stefendy-dotcom/NUSA-APRS-ESP32/docs/RF_REMOTE_ADMIN_EN.md

# RF Remote Admin — English

REV1T accepts short configuration commands through **APRS Messages received directly over RF**. All REV1S commands remain available and REV1T adds GPS Tracker control.

## Authorization

The Web UI stores two administrator identities:

- Admin Callsign 1
- Admin Callsign 2

Matching is **exact callsign+SSID**. If `YF9UAG-9` is configured, `YF9UAG` and `YF9UAG-10` are not administrators.

Packets from any other source:

- do not execute the command;
- receive no admin ACK;
- receive no ERR response;
- cause no RF reply transmission;
- may only be logged locally as denied/silent.

Commands arriving through APRS-IS are not used as RF Remote Admin commands. This control path only uses APRS messages successfully decoded from RF.

## How to send a command

Send the command as an **APRS Message addressed to the NUSA APRS device callsign**. The message body only needs to contain one of the short commands below.

Examples:

```text
STAT
DIGI ON
RXGAIN 0
RFPATH WIDE2-1
SAVE
```

If the transmitting APRS application or radio includes a standard APRS message number, the device also sends the normal APRS ACK first.

## Short commands and their functions

| Command | Function |
|---|---|
| `STAT` | Shows a compact device status: uptime, number of received RF packets, DIGI status, IGATE status, APRS-IS connection status, and free heap. |
| `GET` | Shows the current main operational settings in compact form: DIGI, IGATE, IS→RF, RX squelch, RX decoder gain, TX level, and beacon interval. A trailing `*` means there are changes that have not yet been saved. |
| `DIGI ON` / `DIGI OFF` | Enables or disables the **APRS digipeater** function. |
| `IGATE ON` / `IGATE OFF` | Enables or disables the **RF → APRS-IS iGate** function. |
| `ISRF ON` / `ISRF OFF` | Enables or disables **APRS-IS → RF** gating. |
| `RFBCN ON` / `RFBCN OFF` | Enables or disables the device's **position beacon over RF**. |
| `ISBCN ON` / `ISBCN OFF` | Enables or disables the device's **position beacon directly to APRS-IS**. |
| `RXSQL 135` | Sets the **RX Squelch ADC** threshold. Accepted range: **5–1000**. Example: `RXSQL 55`. |
| `RXGAIN 0` | Sets **RX Decoder Gain**. `0` = AUTO. Accepted manual values: **20–500**. |
| `TXLVL 90` | Sets the AFSK TX audio/modulation level. Accepted range: **10–100**. |
| `BSEC 600` | Sets the beacon interval in **seconds**. Accepted range: **30–86400 seconds**. Example: `600` = 10 minutes. |
| `DDELAY 150` | Sets the **digipeater retransmit delay** in milliseconds. Accepted range: **0–3000 ms**. |
| `DUPSEC 30` | Sets the **duplicate-packet suppression window** in seconds. Accepted range: **5–300 seconds**. |
| `FILTER i/30/0` | Sets the local **IS → RF heard filter**. Format: `i/minutes/hops`. Example: `i/30/0` means the station must have been heard over RF within the last 30 minutes with a maximum of 0 used digipeater hops, i.e. heard directly. |
| `ALIAS WIDE1,WIDE2` | Sets the aliases accepted by the digipeater. A common example is `WIDE1,WIDE2`. Maximum alias configuration length is 40 characters. |
| `RFPATH WIDE2-1` | Sets the path used by the device's **RF beacon**. |
| `RFPATH DIRECT` | Sends the RF beacon **without a digipeater path**. |
| `ISPATH WIDE2-1` | Sets the RF path used when forwarding packets from **APRS-IS → RF**. |
| `ISPATH DIRECT` | Sends **APRS-IS → RF** packets directly without a digipeater path. |
| `COMMENT text` | Changes the device APRS comment. Maximum length: **100 characters**. Example: `COMMENT NUSA APRS IGATE`. |
| `AMODE ON` / `AMODE OFF` | Enables/disables **Auto Mode Switch**. ON: APRS-IS online → iGate, offline → Digipeater. While ON, manual `DIGI`/`IGATE` commands return `ERR AUTO`. |
| `TRK ON` / `TRK OFF` | Enables or disables the **REV1T GPS Tracker** independently from Digi/iGate/IS→RF. |
| `GPS` | Requests compact GPS status. Example: `FIX=1 SAT=10 SPD=45 CRS=128`; without fix: `FIX=0 SAT=3`. |
| `TMODE FIX` | Selects **Fixed Interval** tracker mode. |
| `TMODE SMART` | Selects **SmartBeaconing**. |
| `TSEC 120` | Sets the fixed tracker interval. Range **30–3600 seconds**. |
| `TPATH WIDE2-1` | Sets the dedicated tracker RF path. |
| `TPATH DIRECT` | Sends tracker RF direct without a digipeater path. |
| `TOUT RF` | Tracker output is RF only. |
| `TOUT IS` | Tracker output is APRS-IS only. |
| `TOUT BOTH` | Tracker output is RF and APRS-IS. |
| `TBCN` | Requests a **manual tracker beacon**. GPS mode requires a fresh fix; AUTO may use a valid static fallback. RF still uses the TX queue/CSMA. |
| `OLED ON` / `OLED OFF` | Enables or disables the OLED display. |
| `SAVE` | Saves all remote changes to **NVS**, so they remain active after restart or power-off. |
| `CANCEL` | Cancels unsaved remote changes and restores the last saved configuration. |
| `REBOOT` | Remotely restarts the ESP32 after the `OK REBOOT` reply has been queued for RF transmission. |

### REV1T tracker command example

```text
GPS
TRK ON
TMODE SMART
TPATH WIDE2-1
TOUT BOTH
SAVE
```

`TRK`, `TMODE`, `TSEC`, `TPATH` and `TOUT` are remote configuration changes: a trailing `*` means they have not yet been `SAVE`d. `TBCN` only requests a beacon and does not change configuration.

### Meaning of the `STAT` reply

Example:

```text
UP=12H RX=245 D=0 I=1 A=1 IS=1 H=143K
```

- `UP` = device uptime.
- `RX` = number of RF frames received.
- `D=1` = digipeater ON, `D=0` = OFF.
- `I=1` = effective RF→IS iGate ON, `I=0` = OFF.
- `A=1` = Auto Mode Switch ON, `A=0` = OFF/manual.
- `IS=1` = connected to APRS-IS, `IS=0` = disconnected.
- `H` = ESP32 free heap in KB.

### Meaning of the `GET` reply

Example:

```text
D=0 I=1 A=1 R=1 Q=55 G=0 T=90 B=600 *
```

- `D` = DIGI.
- `I` = effective RF→IS IGATE state.
- `A` = Auto Mode Switch (`1` ON, `0` OFF/manual).
- `R` = IS→RF.
- `Q` = RX Squelch ADC.
- `G` = RX Decoder Gain.
- `T` = TX Level.
- `B` = beacon interval in seconds.
- `*` = configuration changes are present but have **not yet been saved**.

## Usage examples

Temporarily disable the digipeater manually (disable Auto Mode first):

```text
AMODE OFF
DIGI OFF
```

If the result is correct and should be made permanent:

```text
SAVE
```

Discard unsaved remote changes:

```text
CANCEL
```

Set the beacon interval to 10 minutes, enable the RF beacon, and use WIDE2-1:

```text
BSEC 600
RFBCN ON
RFPATH WIDE2-1
SAVE
```

Remote changes take effect in RAM first. Use `SAVE` to commit them to NVS. `CANCEL` restores the last saved remote-configurable values.

Administrator identities, station callsign, Wi-Fi credentials, and critical GPIO assignments cannot be changed through RF Remote.

## Security

Exact callsign+SSID whitelisting is an operational control, **not cryptographic authentication**. APRS source callsigns can be spoofed.
