stefendy-dotcom/NUSA-APRS-ESP32/source/NUSA_APRS_IGATE_DIGI_REV1T_GPS_TRACKER/NUSA_APRS_IGATE_DIGI_REV1T_GPS_TRACKER.ino

#include <Arduino.h>
#include <WiFi.h>
#include <WiFiClient.h>
#include <WebServer.h>
#include <Preferences.h>
#include <esp_system.h>
#include <math.h>
#include <strings.h>
#include <Wire.h>

#include "AFSK.h"
#include "AX25.h"
#include "NusaAppTypes.h"
#include "NusaOled.h"
#include "NusaWeather.h"
#include "NusaAprsPosition.h"
#include "NusaGpsTracker.h"
#include "NusaLogo.h"

// ============================================================================
// NUSA APRS iGate + Digipeater REV1T GPS TRACKER / REV1S ENGINE FROZEN
// Target : Classic ESP32 DevKit / WROOM-32
// RX     : GPIO36 (ADC1_CH0)
// TX AFSK: GPIO26 (internal DAC2)
// PTT    : configurable, default GPIO25
// Web    : AP + local Wi-Fi simultaneously
// ============================================================================

static const char *FW_NAME = "NUSA APRS iGate + Digipeater + GPS Tracker";
static const char *FW_VER  = "REV1T GPS TRACKER";
static const char *APRS_SW = "NUSAESP32";
static const char *APRS_SW_VER = "1.6";

WebServer web(80);
Preferences prefs;
WiFiClient aprsClient;
Afsk afsk;
AX25Ctx ax25;
NusaGpsTracker gps;

enum TrackerPositionMode : uint8_t { TRACK_POS_STATIC = 0, TRACK_POS_GPS = 1, TRACK_POS_AUTO = 2 };
enum TrackerOutputMode : uint8_t { TRACK_OUT_RF = 1, TRACK_OUT_IS = 2, TRACK_OUT_BOTH = 3 };
enum TrackerBeaconMode : uint8_t { TRACK_MODE_FIXED = 0, TRACK_MODE_SMART = 1 };

struct TrackerPosition {
  bool valid = false;
  bool fromGps = false;
  double lat = 0.0;
  double lon = 0.0;
  float speedKmh = 0.0f;
  float courseDeg = 0.0f;
  float altitudeM = 0.0f;
  bool courseValid = false;
  bool altitudeValid = false;
};

struct AppConfig {
  String call = "NOCALL";
  uint8_t ssid = 0;
  String dest = "APZUAG";

  String wifiSsid = "";
  String wifiPass = "";
  String apSsid = "NUSA-APRS-IGATE";
  String apPass = "12345678";

  String isServer = "asia.aprs2.net";
  uint16_t isPort = 14580;
  int32_t isPasscode = 0; // 0 = calculate automatically from callsign
  String isFilter = ""; // APRS-IS server-side filter; blank = server default
  bool igateEnabled = true;
  // REV1T Auto Mode Switch:
  // APRS-IS connected => iGate active, Digi inactive.
  // APRS-IS unavailable/disconnected => iGate inactive, Digi active.
  // Manual igate/digi values remain stored as fallback when Auto Mode is OFF.
  bool autoModeSwitchEnabled = true;

  // Local APRS-IS -> RF message filter.  This is processed by the ESP32,
  // NOT sent to APRS-IS.  i/30/0 = message addressee heard in the last
  // 30 minutes with 0 used digipeater hops (direct RF only).
  bool isToRfEnabled = true;
  String localIsRfFilter = "i/30/0";
  String isToRfPath = ""; // blank = direct RF TX

  bool digiEnabled = false;
  String digiAliases = "WIDE1,WIDE2";
  uint16_t digiDelayMs = 150;
  uint16_t duplicateSec = 30;

  bool rfBeaconEnabled = false;
  bool isBeaconEnabled = false;
  uint32_t beaconSec = 600;
  double lat = 0.0;
  double lon = 0.0;
  char symbolTable = '/';
  char symbolCode = '#';
  String comment = "NUSA ESP32 iGate+Digi";
  String rfPath = "WIDE2-1";

  // REV1T additive GPS tracker. Disabled by default so REV1S upgrades remain safe.
  bool trackerEnabled = false;
  uint8_t trackerPositionMode = TRACK_POS_AUTO;
  int gpsRxPin = 16;
  int gpsTxPin = 17;
  uint32_t gpsBaud = 9600;
  uint16_t gpsStaleSec = 15;
  uint8_t trackerOutput = TRACK_OUT_RF;
  String trackerRfPath = "WIDE2-1";
  char trackerSymbolTable = '/';
  char trackerSymbolCode = '>';
  String trackerComment = "NUSA GPS Tracker";
  uint8_t trackerBeaconMode = TRACK_MODE_FIXED;
  uint16_t trackerFixedSec = 120;
  uint16_t smartSlowSpeedKmh = 5;
  uint16_t smartSlowRateSec = 600;
  uint16_t smartFastSpeedKmh = 80;
  uint16_t smartFastRateSec = 60;
  uint16_t smartTurnAngleDeg = 30;
  uint16_t smartTurnSlope = 255;
  uint16_t smartTurnTimeSec = 15;
  uint16_t stationarySpeedKmh = 3;
  uint16_t trackerMinTxSec = 15;

  uint16_t preambleMs = 350;
  uint16_t tailMs = 80;
  uint8_t txLevel = 90;
  uint16_t rxSquelch = 55;
  uint16_t rxDecoderGain = 0; // 0=AUTO, otherwise manual 20..500%

  int pttPin = 25;
  bool pttActiveHigh = true;
  int rxLedPin = 2;
  int txLedPin = 4;

  // Optional SSD1306 128x64 OLED. 0 address = auto detect 0x3C/0x3D.
  bool oledEnabled = true;
  int oledSdaPin = 21;
  int oledSclPin = 22;
  uint8_t oledAddress = 0;
  uint8_t oledController = 2; // 1=SSD1306, 2=SH1106 (default for tested module)
  uint8_t oledContrast = 180;
  bool oledFlip = false;
  uint8_t oledRotateSec = 4;
  uint8_t oledPopupSec = 10;
  uint16_t oledWeatherMaxAgeMin = 30;

  // RF Remote Admin. Admin identity is configured only from the local Web UI.
  // Up to two exact callsign+SSID values are accepted. Empty = unused.
  bool rfAdminEnabled = false;
  String rfAdmin1 = "";
  String rfAdmin2 = "";
  String rfAdminReplyPath = ""; // blank = DIRECT
} cfg;

// Counters
uint32_t rfRxCount = 0;
uint32_t gatedCount = 0;
uint32_t digiTxCount = 0;
uint32_t rfBeaconCount = 0;
uint32_t isBeaconCount = 0;
uint32_t isRxLineCount = 0;
uint32_t isToRfTxCount = 0;
uint32_t isToRfDropCount = 0;
uint32_t droppedTxCount = 0;
uint32_t lastBeaconMs = 0;
uint32_t lastIsConnectAttempt = 0;
uint32_t lastWifiRetry = 0;
uint32_t rfAdminOkCount = 0;
uint32_t rfAdminDeniedCount = 0;
uint32_t rfAdminReplyCount = 0;
uint32_t trackerRfBeaconCount = 0;
uint32_t trackerIsBeaconCount = 0;
uint32_t trackerSmartSpeedCount = 0;
uint32_t trackerSmartTurnCount = 0;
uint32_t trackerDroppedTxCount = 0;
uint32_t lastTrackerBeaconMs = 0;
uint32_t lastTrackerAttemptMs = 0;
float lastTrackerCourseDeg = 0.0f;
bool lastTrackerCourseValid = false;
String lastTrackerReason = "-";
bool lastGpsConnectedState = false;
bool lastGpsFixState = false;
bool gpsHadFixPreviously = false;
int8_t autoModeLast = -1; // -1 unknown, 0 DIGI, 1 IGATE
bool rfAdminDirty = false;
bool rfAdminRebootPending = false;
uint32_t rfAdminRebootRequestedMs = 0;

// Snapshot of the remote-changeable operational values. CANCEL restores this
// snapshot; SAVE updates NVS and then refreshes the snapshot.
struct RfAdminSavedConfig {
  bool igateEnabled = true;
  bool autoModeSwitchEnabled = true;
  bool isToRfEnabled = true;
  bool digiEnabled = false;
  bool rfBeaconEnabled = false;
  bool isBeaconEnabled = false;
  String localIsRfFilter;
  String isToRfPath;
  String digiAliases;
  uint16_t digiDelayMs = 150;
  uint16_t duplicateSec = 30;
  uint32_t beaconSec = 600;
  String rfPath;
  String comment;
  uint8_t txLevel = 90;
  uint16_t rxSquelch = 55;
  uint16_t rxDecoderGain = 0;
  bool oledEnabled = true;
  bool trackerEnabled = false;
  uint8_t trackerBeaconMode = TRACK_MODE_FIXED;
  uint16_t trackerFixedSec = 120;
  String trackerRfPath;
  uint8_t trackerOutput = TRACK_OUT_RF;
};
RfAdminSavedConfig rfAdminSaved;

// Small log ring.
static const uint8_t LOG_LINES = 50;
String logBuf[LOG_LINES];
uint8_t logHead = 0;
uint8_t logUsed = 0;

// RF transmit queue. All RF TX goes through CSMA/channel-busy checking.
static const uint8_t TX_QUEUE_SIZE = 8;
TxJob txQueue[TX_QUEUE_SIZE];
uint8_t txHead = 0, txTail = 0;

DupEntry dupCache[32];
uint8_t dupPos = 0;

// Separate duplicate cache for APRS-IS -> RF message gating.
DupEntry isToRfDupCache[32];
uint8_t isToRfDupPos = 0;

// RF heard table. One timestamp is retained for each observed used-digi-hop
// count. i/30/0 therefore checks only lastByHops[0].
static const uint8_t HEARD_SLOTS = 48;
HeardEntry rfHeard[HEARD_SLOTS];

// Tracks stations observed as Internet-originated (TCPIP*/TCPXX*).
InternetHeardEntry internetHeard[HEARD_SLOTS];

// IS->RF transmit rate limiter: max 6 packets/1 min and 10 packets/5 min.
uint32_t isToRfTxHistory[10] = {0};
uint8_t isToRfTxHistoryPos = 0;

String isLineBuffer;

// OLED / local RF event state. OLED is display-only and never participates
// in the modem timing path.
NusaOled oled;
NusaWeatherData lastWeather;
String lastRfSource = "-";
String lastRfDestination = "-";
String lastRfSummary = "";
uint32_t lastRfEventMs = 0;
uint32_t oledWeatherPopupUntil = 0;
uint32_t oledPacketPopupUntil = 0;
uint32_t oledLastRefreshMs = 0;
uint32_t oledLastPageMs = 0;

uint8_t oledPage = 0;

// Six newest RF stations that supplied a valid APRS position.
// The bearing/distance reference is cfg.lat/cfg.lon (this iGate/digipeater).
struct OledHeardPos {
  bool used = false;
  String call;
  double lat = 0.0;
  double lon = 0.0;
  uint16_t bearingDeg = 0;
  float distanceKm = 0.0f;
  uint32_t whenMs = 0;
};
static const uint8_t OLED_HEARD_ROWS = 6;
OledHeardPos oledHeard[OLED_HEARD_ROWS];       // newest RF position packets
OledHeardPos oledIsHeard[OLED_HEARD_ROWS];     // newest APRS-IS position packets

static bool queueRf(const uint8_t *raw, size_t len, TxKind kind, uint32_t delayMs);
static void noteOledIsHeardPosition(const IsPacketInfo &p);
static void applyModemConfig();
static void initOled();
static bool processRfAdminMessage(const AX25Msg &m);
static void serviceRfAdmin();
static bool autoNetworkAvailable();
static bool effectiveIgateEnabled();
static bool effectiveDigiEnabled();
static void serviceAutoModeSwitch();
static bool gpsPinsSafe();
static void initGps();
static bool sendTrackerBeacon(bool manual, const char *reason);
static void serviceTracker();

static void addLog(const String &s) {
  String line = String(millis() / 1000UL) + "s  " + s;
  Serial.println(line);
  logBuf[logHead] = line;
  logHead = (uint8_t)((logHead + 1) % LOG_LINES);
  if (logUsed < LOG_LINES) ++logUsed;
}

static bool autoNetworkAvailable() {
  // End-to-end criterion: Wi-Fi is associated AND the APRS-IS TCP session is
  // authenticated/connected. This also catches "Wi-Fi connected but Internet
  // unavailable" and APRS-IS route failures, where acting as a digipeater is
  // more useful than pretending the iGate is online.
  return WiFi.status() == WL_CONNECTED && aprsClient.connected();
}

static bool effectiveIgateEnabled() {
  return cfg.autoModeSwitchEnabled ? autoNetworkAvailable() : cfg.igateEnabled;
}

static bool effectiveDigiEnabled() {
  return cfg.autoModeSwitchEnabled ? !autoNetworkAvailable() : cfg.digiEnabled;
}

static void serviceAutoModeSwitch() {
  if (!cfg.autoModeSwitchEnabled) {
    if (autoModeLast != -1) {
      addLog("AUTO MODE OFF -> manual IGATE=" + String(cfg.igateEnabled ? "ON" : "OFF") +
             " DIGI=" + String(cfg.digiEnabled ? "ON" : "OFF"));
      autoModeLast = -1;
    }
    return;
  }
  int8_t mode = autoNetworkAvailable() ? 1 : 0;
  if (mode == autoModeLast) return;
  autoModeLast = mode;
  if (mode == 1) addLog("AUTO MODE -> IGATE (APRS-IS connected), DIGI OFF");
  else addLog("AUTO MODE -> DIGI (Internet/APRS-IS unavailable), IGATE OFF");
}

static String htmlEscape(String s) {
  s.replace("&", "&amp;");
  s.replace("<", "&lt;");
  s.replace(">", "&gt;");
  s.replace("\"", "&quot;");
  s.replace("'", "&#39;");
  return s;
}

static String jsonEscape(String s) {
  s.replace("\\", "\\\\");
  s.replace("\"", "\\\"");
  s.replace("\r", "\\r");
  s.replace("\n", "\\n");
  return s;
}

static String sanitizeBaseCall(String in) {
  in.trim(); in.toUpperCase();
  int dash = in.indexOf('-');
  if (dash >= 0) in = in.substring(0, dash);
  String out;
  for (size_t i = 0; i < in.length() && out.length() < 6; ++i) {
    char c = in[i];
    if (isalnum((unsigned char)c)) out += c;
  }
  return out.length() ? out : String("NOCALL");
}

static String singleLine(String s) {
  s.replace("\r", " ");
  s.replace("\n", " ");
  return s;
}

static String stationCall() {
  String s = sanitizeBaseCall(cfg.call);
  if (cfg.ssid > 0) s += "-" + String(cfg.ssid);
  return s;
}

static String callToString(const AX25Call &c, bool star = false) {
  String s(c.call);
  if (c.ssid > 0) s += "-" + String(c.ssid);
  if (star) s += '*';
  return s;
}

static bool parseCallText(String text, AX25Call &out) {
  text.trim(); text.toUpperCase();
  bool repeated = text.endsWith("*");
  if (repeated) text.remove(text.length() - 1);
  int dash = text.indexOf('-');
  String base = dash >= 0 ? text.substring(0, dash) : text;
  int ssid = dash >= 0 ? text.substring(dash + 1).toInt() : 0;
  base = sanitizeBaseCall(base);
  if (base == "NOCALL" || ssid < 0 || ssid > 15) return false;
  out = ax25_makeCall(base.c_str(), (uint8_t)ssid);
  return true;
}

static uint8_t parsePath(const String &pathText, AX25Call out[AX25_MAX_RPT]) {
  String p = pathText;
  p.trim(); p.toUpperCase();
  if (!p.length()) return 0;
  uint8_t n = 0;
  int start = 0;
  while (start < (int)p.length() && n < AX25_MAX_RPT) {
    int comma = p.indexOf(',', start);
    String token = comma < 0 ? p.substring(start) : p.substring(start, comma);
    token.trim();
    AX25Call c{};
    if (token.length() && parseCallText(token, c)) out[n++] = c;
    if (comma < 0) break;
    start = comma + 1;
  }
  return n;
}

static bool sameCall(const AX25Call &a, const AX25Call &b) {
  return strcasecmp(a.call, b.call) == 0 && a.ssid == b.ssid;
}

static String normalizeCallSsid(String s) {
  s.trim(); s.toUpperCase();
  if (!s.length()) return "";
  int dash = s.indexOf('-');
  if (dash >= 0) {
    String ss = s.substring(dash + 1);
    if (!ss.length() || ss.length() > 2) return "";
    for (size_t i = 0; i < ss.length(); ++i) if (!isdigit((unsigned char)ss[i])) return "";
    int n = ss.toInt();
    if (n < 0 || n > 15) return "";
  }
  AX25Call c{};
  if (!parseCallText(s, c)) return "";
  return callToString(c);
}

static bool rfAdminIsAuthorized(const AX25Call &src) {
  String s = callToString(src); s.toUpperCase();
  return (cfg.rfAdmin1.length() && s == cfg.rfAdmin1) ||
         (cfg.rfAdmin2.length() && s == cfg.rfAdmin2);
}

static bool parseOnOff(String s, bool &v) {
  s.trim(); s.toUpperCase();
  if (s == "ON" || s == "1") { v = true; return true; }
  if (s == "OFF" || s == "0") { v = false; return true; }
  return false;
}

static bool validPathText(String p) {
  p.trim(); p.toUpperCase();
  if (!p.length() || p == "DIRECT") return true;
  uint8_t count = 0;
  int start = 0;
  while (start < (int)p.length()) {
    int comma = p.indexOf(',', start);
    String token = comma < 0 ? p.substring(start) : p.substring(start, comma);
    token.trim();
    if (!token.length()) return false;
    AX25Call c{};
    if (!parseCallText(token, c)) return false;
    if (++count > AX25_MAX_RPT) return false;
    if (comma < 0) break;
    start = comma + 1;
  }
  return count > 0;
}

static String remoteDirtySuffix() { return rfAdminDirty ? " *" : ""; }

static void captureRfAdminSavedConfig() {
  rfAdminSaved.igateEnabled = cfg.igateEnabled;
  rfAdminSaved.autoModeSwitchEnabled = cfg.autoModeSwitchEnabled;
  rfAdminSaved.isToRfEnabled = cfg.isToRfEnabled;
  rfAdminSaved.digiEnabled = cfg.digiEnabled;
  rfAdminSaved.rfBeaconEnabled = cfg.rfBeaconEnabled;
  rfAdminSaved.isBeaconEnabled = cfg.isBeaconEnabled;
  rfAdminSaved.localIsRfFilter = cfg.localIsRfFilter;
  rfAdminSaved.isToRfPath = cfg.isToRfPath;
  rfAdminSaved.digiAliases = cfg.digiAliases;
  rfAdminSaved.digiDelayMs = cfg.digiDelayMs;
  rfAdminSaved.duplicateSec = cfg.duplicateSec;
  rfAdminSaved.beaconSec = cfg.beaconSec;
  rfAdminSaved.rfPath = cfg.rfPath;
  rfAdminSaved.comment = cfg.comment;
  rfAdminSaved.txLevel = cfg.txLevel;
  rfAdminSaved.rxSquelch = cfg.rxSquelch;
  rfAdminSaved.rxDecoderGain = cfg.rxDecoderGain;
  rfAdminSaved.oledEnabled = cfg.oledEnabled;
  rfAdminSaved.trackerEnabled = cfg.trackerEnabled;
  rfAdminSaved.trackerBeaconMode = cfg.trackerBeaconMode;
  rfAdminSaved.trackerFixedSec = cfg.trackerFixedSec;
  rfAdminSaved.trackerRfPath = cfg.trackerRfPath;
  rfAdminSaved.trackerOutput = cfg.trackerOutput;
  rfAdminDirty = false;
}

static void restoreRfAdminSavedConfig() {
  bool oldOled = cfg.oledEnabled;
  cfg.igateEnabled = rfAdminSaved.igateEnabled;
  cfg.autoModeSwitchEnabled = rfAdminSaved.autoModeSwitchEnabled;
  cfg.isToRfEnabled = rfAdminSaved.isToRfEnabled;
  cfg.digiEnabled = rfAdminSaved.digiEnabled;
  cfg.rfBeaconEnabled = rfAdminSaved.rfBeaconEnabled;
  cfg.isBeaconEnabled = rfAdminSaved.isBeaconEnabled;
  cfg.localIsRfFilter = rfAdminSaved.localIsRfFilter;
  cfg.isToRfPath = rfAdminSaved.isToRfPath;
  cfg.digiAliases = rfAdminSaved.digiAliases;
  cfg.digiDelayMs = rfAdminSaved.digiDelayMs;
  cfg.duplicateSec = rfAdminSaved.duplicateSec;
  cfg.beaconSec = rfAdminSaved.beaconSec;
  cfg.rfPath = rfAdminSaved.rfPath;
  cfg.comment = rfAdminSaved.comment;
  cfg.txLevel = rfAdminSaved.txLevel;
  cfg.rxSquelch = rfAdminSaved.rxSquelch;
  cfg.rxDecoderGain = rfAdminSaved.rxDecoderGain;
  cfg.oledEnabled = rfAdminSaved.oledEnabled;
  cfg.trackerEnabled = rfAdminSaved.trackerEnabled;
  cfg.trackerBeaconMode = rfAdminSaved.trackerBeaconMode;
  cfg.trackerFixedSec = rfAdminSaved.trackerFixedSec;
  cfg.trackerRfPath = rfAdminSaved.trackerRfPath;
  cfg.trackerOutput = rfAdminSaved.trackerOutput;
  applyModemConfig();
  if (oldOled && !cfg.oledEnabled && oled.ready()) oled.end();
  if (!oldOled && cfg.oledEnabled && !oled.ready()) initOled();
  rfAdminDirty = false;
}

static void persistRfAdminOperationalConfig() {
  prefs.begin("nusaaprs", false);
  prefs.putBool("igate", cfg.igateEnabled);
  prefs.putBool("automode", cfg.autoModeSwitchEnabled);
  prefs.putBool("is2rf", cfg.isToRfEnabled);
  prefs.putString("isrfflt", cfg.localIsRfFilter);
  prefs.putString("isrfpath", cfg.isToRfPath);
  prefs.putBool("digi", cfg.digiEnabled);
  prefs.putString("alias", cfg.digiAliases);
  prefs.putUShort("ddelay", cfg.digiDelayMs);
  prefs.putUShort("dupsec", cfg.duplicateSec);
  prefs.putBool("rfbcn", cfg.rfBeaconEnabled);
  prefs.putBool("isbcn", cfg.isBeaconEnabled);
  prefs.putUInt("bsec", cfg.beaconSec);
  prefs.putString("comment", cfg.comment);
  prefs.putString("path", cfg.rfPath);
  prefs.putUChar("txlvl", cfg.txLevel);
  prefs.putUShort("rxsql", cfg.rxSquelch);
  prefs.putUShort("rxgain", cfg.rxDecoderGain);
  prefs.putBool("oled", cfg.oledEnabled);
  prefs.putBool("trken", cfg.trackerEnabled);
  prefs.putUChar("trmode", cfg.trackerBeaconMode);
  prefs.putUShort("trsec", cfg.trackerFixedSec);
  prefs.putString("trpath", cfg.trackerRfPath);
  prefs.putUChar("trout", cfg.trackerOutput);
  prefs.end();
  captureRfAdminSavedConfig();
}

static bool aliasAllowed(const AX25Call &c) {
  String list = cfg.digiAliases;
  list.toUpperCase();
  int start = 0;
  while (start <= (int)list.length()) {
    int comma = list.indexOf(',', start);
    String token = comma < 0 ? list.substring(start) : list.substring(start, comma);
    token.trim();
    int dash = token.indexOf('-');
    if (dash >= 0) token = token.substring(0, dash);
    if (token.equalsIgnoreCase(c.call)) return true;
    if (comma < 0) break;
    start = comma + 1;
  }
  return false;
}

static uint32_t packetHash(const AX25Msg &m) {
  uint32_t h = 2166136261UL;
  auto mix = [&](uint8_t b) { h ^= b; h *= 16777619UL; };
  for (const char *p = m.src.call; *p; ++p) mix((uint8_t)*p);
  mix(m.src.ssid);
  for (const char *p = m.dst.call; *p; ++p) mix((uint8_t)*p);
  mix(m.dst.ssid);
  for (size_t i = 0; i < m.len; ++i) mix(m.info[i]);
  return h;
}

static bool duplicateRecently(uint32_t h) {
  uint32_t now = millis();
  uint32_t window = (uint32_t)cfg.duplicateSec * 1000UL;
  for (auto &e : dupCache) {
    if (e.hash == h && (uint32_t)(now - e.when) < window) return true;
  }
  dupCache[dupPos] = {h, now};
  dupPos = (uint8_t)((dupPos + 1) % 32);
  return false;
}

static bool digitsOnly(const String &s) {
  if (!s.length()) return false;
  for (size_t i = 0; i < s.length(); ++i) if (!isdigit((unsigned char)s[i])) return false;
  return true;
}

static LocalIsRfSpec parseLocalIsRfFilter(String f) {
  LocalIsRfSpec spec;
  f.trim(); f.toLowerCase();
  if (!f.startsWith("i/")) return spec;
  int p1 = f.indexOf('/', 2);
  String mins = p1 < 0 ? f.substring(2) : f.substring(2, p1);
  String hops = p1 < 0 ? String("0") : f.substring(p1 + 1);
  if (hops.indexOf('/') >= 0) return spec; // REV1E supports i/time/hops only
  if (!digitsOnly(mins) || !digitsOnly(hops)) return spec;
  int m = mins.toInt();
  int h = hops.toInt();
  if (m < 1 || m > 1440 || h < 0 || h > HEARD_HOPS_MAX) return spec;
  spec.valid = true;
  spec.minutes = (uint16_t)m;
  spec.maxHops = (uint8_t)h;
  return spec;
}

static uint8_t usedDigiHops(const AX25Msg &m) {
  uint8_t hops = 0;
  for (uint8_t i = 0; i < m.rpt_count; ++i) {
    if (m.rpt_flags & BV(i)) ++hops;
  }
  return hops > HEARD_HOPS_MAX ? HEARD_HOPS_MAX : hops;
}

static uint32_t newestHeardMs(const HeardEntry &e) {
  uint32_t newest = 0;
  for (uint8_t h = 0; h <= HEARD_HOPS_MAX; ++h) {
    if (e.lastByHops[h] && (!newest || (int32_t)(e.lastByHops[h] - newest) > 0)) newest = e.lastByHops[h];
  }
  return newest;
}

static int findRfHeardSlot(const String &call, bool create) {
  int freeSlot = -1;
  int oldestSlot = 0;
  uint32_t oldestTime = 0xFFFFFFFFUL;
  for (uint8_t i = 0; i < HEARD_SLOTS; ++i) {
    if (rfHeard[i].used) {
      if (call.equalsIgnoreCase(rfHeard[i].call)) return i;
      uint32_t t = newestHeardMs(rfHeard[i]);
      if (t < oldestTime) { oldestTime = t; oldestSlot = i; }
    } else if (freeSlot < 0) {
      freeSlot = i;
    }
  }
  if (!create) return -1;
  int slot = freeSlot >= 0 ? freeSlot : oldestSlot;
  rfHeard[slot] = HeardEntry();
  rfHeard[slot].used = true;
  strncpy(rfHeard[slot].call, call.c_str(), sizeof(rfHeard[slot].call) - 1);
  rfHeard[slot].call[sizeof(rfHeard[slot].call) - 1] = 0;
  return slot;
}

static void noteRfHeard(const AX25Msg &m) {
  String c = callToString(m.src); c.toUpperCase();
  if (!c.length() || c.equalsIgnoreCase(stationCall())) return;
  int slot = findRfHeardSlot(c, true);
  if (slot < 0) return;
  uint8_t hops = usedDigiHops(m);
  bool wasEligibleDirect = rfHeard[slot].lastByHops[0] &&
      (uint32_t)(millis() - rfHeard[slot].lastByHops[0]) <= 30UL * 60UL * 1000UL;
  rfHeard[slot].lastByHops[hops] = millis();
  if (hops == 0 && !wasEligibleDirect) addLog("HEARD DIRECT + " + c + " (i/30/0 eligible)");
}

static bool rfHeardWithin(const String &call, uint16_t minutes, uint8_t maxHops, uint32_t *ageMs = nullptr) {
  int slot = findRfHeardSlot(call, false);
  if (slot < 0) return false;
  uint32_t now = millis();
  uint32_t window = (uint32_t)minutes * 60UL * 1000UL;
  uint32_t bestAge = 0xFFFFFFFFUL;
  if (maxHops > (uint8_t)HEARD_HOPS_MAX) maxHops = (uint8_t)HEARD_HOPS_MAX;
  for (uint8_t h = 0; h <= maxHops; ++h) {
    uint32_t t = rfHeard[slot].lastByHops[h];
    if (!t) continue;
    uint32_t age = now - t;
    if (age <= window && age < bestAge) bestAge = age;
  }
  if (bestAge == 0xFFFFFFFFUL) return false;
  if (ageMs) *ageMs = bestAge;
  return true;
}

static int findInternetHeardSlot(const String &call, bool create) {
  int freeSlot = -1;
  int oldestSlot = 0;
  uint32_t oldest = 0xFFFFFFFFUL;
  for (uint8_t i = 0; i < HEARD_SLOTS; ++i) {
    if (internetHeard[i].used) {
      if (call.equalsIgnoreCase(internetHeard[i].call)) return i;
      if (internetHeard[i].lastSeen < oldest) { oldest = internetHeard[i].lastSeen; oldestSlot = i; }
    } else if (freeSlot < 0) freeSlot = i;
  }
  if (!create) return -1;
  int slot = freeSlot >= 0 ? freeSlot : oldestSlot;
  internetHeard[slot] = InternetHeardEntry();
  internetHeard[slot].used = true;
  strncpy(internetHeard[slot].call, call.c_str(), sizeof(internetHeard[slot].call) - 1);
  internetHeard[slot].call[sizeof(internetHeard[slot].call) - 1] = 0;
  return slot;
}

static void noteInternetHeard(const String &call) {
  if (!call.length()) return;
  int slot = findInternetHeardSlot(call, true);
  if (slot >= 0) internetHeard[slot].lastSeen = millis();
}

static bool internetHeardWithin(const String &call, uint16_t minutes) {
  int slot = findInternetHeardSlot(call, false);
  if (slot < 0 || !internetHeard[slot].lastSeen) return false;
  return (uint32_t)(millis() - internetHeard[slot].lastSeen) <= (uint32_t)minutes * 60UL * 1000UL;
}

static uint32_t hashStringFNV1a(const String &s) {
  uint32_t h = 2166136261UL;
  for (size_t i = 0; i < s.length(); ++i) { h ^= (uint8_t)s[i]; h *= 16777619UL; }
  return h;
}

static bool isToRfDuplicate(const String &line) {
  uint32_t h = hashStringFNV1a(line);
  uint32_t now = millis();
  const uint32_t window = 30000UL;
  for (auto &e : isToRfDupCache) {
    if (e.hash == h && (uint32_t)(now - e.when) < window) return true;
  }
  isToRfDupCache[isToRfDupPos] = {h, now};
  isToRfDupPos = (uint8_t)((isToRfDupPos + 1) % 32);
  return false;
}

static bool isToRfRateAllowed() {
  uint32_t now = millis();
  uint8_t oneMin = 0, fiveMin = 0;
  for (uint8_t i = 0; i < 10; ++i) {
    if (!isToRfTxHistory[i]) continue;
    uint32_t age = now - isToRfTxHistory[i];
    if (age < 60000UL) ++oneMin;
    if (age < 300000UL) ++fiveMin;
  }
  return oneMin < 6 && fiveMin < 10;
}

static void noteIsToRfTxNow() {
  isToRfTxHistory[isToRfTxHistoryPos] = millis();
  isToRfTxHistoryPos = (uint8_t)((isToRfTxHistoryPos + 1) % 10);
}

static IsPacketInfo parseAprsIsLine(const String &line) {
  IsPacketInfo p;
  if (!line.length() || line[0] == '#') return p;
  int colon = line.indexOf(':');
  int gt = line.indexOf('>');
  if (colon < 0 || gt <= 0 || gt > colon) return p;

  p.src = line.substring(0, gt); p.src.trim(); p.src.toUpperCase();
  String route = line.substring(gt + 1, colon);
  int comma = route.indexOf(',');
  p.dst = comma < 0 ? route : route.substring(0, comma);
  p.dst.trim(); p.dst.toUpperCase();
  p.info = line.substring(colon + 1); // preserve message text exactly
  if (!p.src.length() || !p.dst.length()) return p;

  if (comma >= 0) {
    int start = comma + 1;
    while (start <= (int)route.length()) {
      int c = route.indexOf(',', start);
      String token = c < 0 ? route.substring(start) : route.substring(start, c);
      token.trim(); token.toUpperCase();
      if (token == "TCPXX" || token == "TCPXX*") { p.internetOrigin = true; p.forbiddenToRf = true; }
      if (token == "TCPIP" || token == "TCPIP*") p.internetOrigin = true;
      if (token == "NOGATE" || token == "NOGATE*" || token == "RFONLY" || token == "RFONLY*") p.forbiddenToRf = true;
      if (c < 0) break;
      start = c + 1;
    }
  }

  if (p.info.length() >= 11 && p.info[0] == ':' && p.info[10] == ':') {
    p.addressee = p.info.substring(1, 10);
    p.addressee.trim(); p.addressee.toUpperCase();
    p.message = p.addressee.length() > 0;
  }
  p.valid = true;
  return p;
}

static bool buildIsToRfThirdParty(const IsPacketInfo &p, uint8_t *raw, size_t *rawLen) {
  if (!raw || !rawLen || !p.valid || !p.message) return false;
  AX25Call src = ax25_makeCall(cfg.call.c_str(), cfg.ssid);
  AX25Call dst{};
  if (!parseCallText(cfg.dest, dst)) dst = ax25_makeCall("APNU01", 0);
  AX25Call path[AX25_MAX_RPT]{};
  uint8_t pathCount = parsePath(cfg.isToRfPath, path);

  // Mandatory third-party Internet->RF representation.  APRS-IS q constructs
  // and server path are intentionally discarded.
  String third = "}" + p.src + ">" + p.dst + ",TCPIP," + stationCall() + "*:" + p.info;
  if (third.length() > AX25_MAX_INFO_LEN) return false;
  return ax25_buildUI(raw, rawLen, &dst, &src, path, pathCount, 0,
                      (const uint8_t *)third.c_str(), third.length());
}

static void processAprsIsLine(const String &line) {
  IsPacketInfo p = parseAprsIsLine(line);
  if (!p.valid) return;

  // OLED APRS-IS heard page is intentionally updated BEFORE any local
  // IS->RF eligibility/filter decision.  Therefore a station position can be
  // displayed even when the packet will never be retransmitted to RF.
  noteOledIsHeardPosition(p);

  // Maintain the Internet-heard state even for non-message packets.
  if (p.internetOrigin) noteInternetHeard(p.src);

  if (!cfg.isToRfEnabled || !p.message) return;
  LocalIsRfSpec spec = parseLocalIsRfFilter(cfg.localIsRfFilter);
  if (!spec.valid) {
    ++isToRfDropCount;
    addLog("IS>RF DROP invalid local filter: " + cfg.localIsRfFilter);
    return;
  }

  if (p.forbiddenToRf) {
    ++isToRfDropCount;
    addLog("IS>RF DROP forbidden path: " + p.src + " > " + p.addressee);
    return;
  }
  if (p.addressee.equalsIgnoreCase(stationCall())) return; // message is for this IGate itself

  uint32_t targetAge = 0;
  if (!rfHeardWithin(p.addressee, spec.minutes, spec.maxHops, &targetAge)) {
    ++isToRfDropCount;
    addLog("IS>RF DROP target not i/" + String(spec.minutes) + "/" + String(spec.maxHops) + ": " + p.addressee);
    return;
  }

  // Standard IGate safeguards in addition to the requested i/time/hops rule.
  if (rfHeardWithin(p.src, spec.minutes, HEARD_HOPS_MAX)) {
    ++isToRfDropCount;
    addLog("IS>RF DROP sender also heard on RF: " + p.src);
    return;
  }
  if (internetHeardWithin(p.addressee, spec.minutes)) {
    ++isToRfDropCount;
    addLog("IS>RF DROP target seen on Internet: " + p.addressee);
    return;
  }
  if (isToRfDuplicate(line)) {
    ++isToRfDropCount;
    addLog("IS>RF duplicate suppressed: " + p.src + " > " + p.addressee);
    return;
  }

  uint8_t raw[AX25_MAX_FRAME_LEN];
  size_t rawLen = 0;
  if (!buildIsToRfThirdParty(p, raw, &rawLen)) {
    ++isToRfDropCount;
    addLog("IS>RF DROP packet too long/invalid: " + p.src + " > " + p.addressee);
    return;
  }

  if (queueRf(raw, rawLen, TX_IS_TO_RF, 0)) {
    addLog("IS>RF queued " + p.src + " > " + p.addressee + "  target age=" + String(targetAge / 1000UL) + "s");
  } else {
    ++isToRfDropCount;
  }
}

static bool queueRf(const uint8_t *raw, size_t len, TxKind kind, uint32_t delayMs) {
  if (!raw || len == 0 || len > AX25_MAX_FRAME_LEN) return false;
  uint8_t next = (uint8_t)((txTail + 1) % TX_QUEUE_SIZE);
  if (next == txHead) {
    ++droppedTxCount;
    addLog("RF TX queue full - packet dropped");
    return false;
  }
  txQueue[txTail].len = (uint16_t)len;
  memcpy(txQueue[txTail].data, raw, len);
  txQueue[txTail].queued = millis();
  txQueue[txTail].due = millis() + delayMs;
  txQueue[txTail].kind = kind;
  txTail = next;
  return true;
}

static bool timeReached(uint32_t now, uint32_t target) {
  return (int32_t)(now - target) >= 0;
}

static int aprsPasscode(String call) {
  call.toUpperCase();
  int dash = call.indexOf('-');
  if (dash >= 0) call = call.substring(0, dash);
  uint16_t hash = 0x73E2;
  for (size_t i = 0; i < call.length(); i += 2) {
    hash ^= ((uint16_t)(uint8_t)call[i]) << 8;
    if (i + 1 < call.length()) hash ^= (uint8_t)call[i + 1];
  }
  return hash & 0x7FFF;
}

static bool hasForbiddenGatePath(const AX25Msg &m) {
  for (uint8_t i = 0; i < m.rpt_count; ++i) {
    String c(m.rpt_list[i].call); c.toUpperCase();
    if (c == "TCPIP" || c == "TCPXX" || c == "NOGATE" || c == "RFONLY") return true;
  }
  return m.len > 0 && m.info[0] == '}'; // do not re-gate third-party encapsulated frames
}

static String msgToTnc2(const AX25Msg &m) {
  String line = callToString(m.src) + ">" + callToString(m.dst);
  for (uint8_t i = 0; i < m.rpt_count; ++i) {
    line += ',';
    line += callToString(m.rpt_list[i], (m.rpt_flags & BV(i)) != 0);
  }
  line += ':';
  for (size_t i = 0; i < m.len; ++i) {
    char c = (char)m.info[i];
    if (c == '\r' || c == '\n' || c == 0) continue;
    line += c;
  }
  return line;
}

static void gateToAprsIs(const AX25Msg &m) {
  if (!effectiveIgateEnabled() || !aprsClient.connected() || hasForbiddenGatePath(m)) return;
  if (sameCall(m.src, ax25_makeCall(cfg.call.c_str(), cfg.ssid))) return;

  String rf = msgToTnc2(m);
  int colon = rf.indexOf(':');
  if (colon < 0) return;
  String line = rf.substring(0, colon) + ",qAR," + stationCall() + rf.substring(colon) + "\r\n";
  aprsClient.print(line);
  ++gatedCount;
  addLog("IGATE > IS  " + line.substring(0, line.length() - 2));
}

static void maybeDigipeat(const AX25Msg &m) {
  if (!effectiveDigiEnabled() || m.rpt_count == 0) return;

  AX25Call own = ax25_makeCall(cfg.call.c_str(), cfg.ssid);
  if (sameCall(m.src, own)) return;
  for (uint8_t i = 0; i < m.rpt_count; ++i) {
    if (sameCall(m.rpt_list[i], own) && (m.rpt_flags & BV(i))) return;
  }

  int idx = -1;
  for (uint8_t i = 0; i < m.rpt_count; ++i) {
    if (!(m.rpt_flags & BV(i))) { idx = i; break; }
  }
  if (idx < 0) return;

  bool directOwn = sameCall(m.rpt_list[idx], own);
  bool wideAlias = aliasAllowed(m.rpt_list[idx]) && m.rpt_list[idx].ssid > 0;
  if (!directOwn && !wideAlias) return;

  uint32_t h = packetHash(m);
  if (duplicateRecently(h)) {
    addLog("DIGI duplicate suppressed: " + callToString(m.src));
    return;
  }

  AX25Call newPath[AX25_MAX_RPT]{};
  uint8_t newFlags = 0;
  uint8_t n = 0;

  for (int i = 0; i < idx && n < AX25_MAX_RPT; ++i) {
    newPath[n] = m.rpt_list[i];
    if (m.rpt_flags & BV(i)) newFlags |= BV(n);
    ++n;
  }

  if (directOwn) {
    if (n >= AX25_MAX_RPT) return;
    newPath[n] = own;
    newFlags |= BV(n);
    ++n;
  } else {
    uint8_t hops = m.rpt_list[idx].ssid;
    if (n >= AX25_MAX_RPT) return;
    newPath[n] = own;
    newFlags |= BV(n);
    ++n;
    if (hops > 1) {
      if (n >= AX25_MAX_RPT) return;
      newPath[n] = m.rpt_list[idx];
      newPath[n].ssid = hops - 1;
      ++n;
    }
  }

  for (uint8_t i = (uint8_t)(idx + 1); i < m.rpt_count && n < AX25_MAX_RPT; ++i) {
    newPath[n] = m.rpt_list[i];
    if (m.rpt_flags & BV(i)) newFlags |= BV(n);
    ++n;
  }

  uint8_t raw[AX25_MAX_FRAME_LEN];
  size_t rawLen = 0;
  if (!ax25_buildUI(raw, &rawLen, &m.dst, &m.src, newPath, n, newFlags, m.info, m.len)) return;

  uint32_t dly = cfg.digiDelayMs + (uint32_t)random(0, 51);
  if (queueRf(raw, rawLen, TX_DIGI, dly)) {
    addLog("DIGI queued: " + callToString(m.src) + ">" + callToString(m.dst));
  }
}


static String clipText(String x, uint8_t n) {
  x.replace("\r", " "); x.replace("\n", " "); x.toUpperCase();
  if (x.length() > n) x = x.substring(0, n);
  return x;
}

static String decoderShortName() {
  uint8_t d = AFSK_getLastFrameDecoder();
  if (d == 1) return "A";
  if (d == 2) return "B-RAW";
  if (d == 3) return "B-EQ125";
  if (d == 4) return "B-EQ130";
  return "-";
}

static bool oledPinsSafe() {
  if (cfg.oledSdaPin < 0 || cfg.oledSdaPin > 33 || cfg.oledSclPin < 0 || cfg.oledSclPin > 33) return false;
  if (cfg.oledSdaPin == cfg.oledSclPin) return false;
  if (cfg.oledSdaPin == 26 || cfg.oledSclPin == 26 || cfg.oledSdaPin == 36 || cfg.oledSclPin == 36) return false;
  if (cfg.oledSdaPin == cfg.pttPin || cfg.oledSclPin == cfg.pttPin) return false;
  if (cfg.oledSdaPin == cfg.rxLedPin || cfg.oledSclPin == cfg.rxLedPin) return false;
  if (cfg.oledSdaPin == cfg.txLedPin || cfg.oledSclPin == cfg.txLedPin) return false;
  return true;
}

static void oledHeader(const String &title) {
  oled.fillRect(0, 0, 128, 10, true);
  oled.text(3, 1, title, 1, true);
}


static void oledDrawBitmap128x64(const uint8_t *bmp) {
  if (!bmp) return;
  for (int page = 0; page < 8; ++page) {
    for (int x = 0; x < 128; ++x) {
      uint8_t b = pgm_read_byte(bmp + page * 128 + x);
      for (int bit = 0; bit < 8; ++bit) {
        oled.pixel(x, page * 8 + bit, (b >> bit) & 0x01);
      }
    }
  }
}

static String weatherAgeText() {
  if (!lastWeather.valid) return "-";
  uint32_t age = (millis() - lastWeather.whenMs) / 1000UL;
  if (age < 60) return String(age) + "S";
  return String(age / 60UL) + "M";
}

static void drawOledLogo() {
  oled.clear();
  oledDrawBitmap128x64(NUSA_APRS_LOGO_128X64);
}

static void drawOledHome() {
  oled.clear(); oledHeader("NUSA APRS " + String(FW_VER));
  String call = stationCall();
  oled.centered(14, call, call.length() <= 8 ? 2 : 1);
  bool isok = aprsClient.connected();
  oled.text(1, 34, "IS:" + String(isok ? "OK" : "--") + " IG:" + String(effectiveIgateEnabled() ? "ON" : "OFF"));
  oled.text(1, 43, "DGI:" + String(effectiveDigiEnabled() ? "ON" : "OFF") + " RF:" + String(AFSK_channelBusy() ? "BUSY" : "CLEAR"));
  oled.text(1, 53, "RX:" + String(rfRxCount) + " TX:" + String(digiTxCount));
}

static void drawOledRf() {
  oled.clear(); oledHeader("RF / DECODER");
  oled.text(1, 13, "LAST:" + decoderShortName());
  oled.text(1, 22, "AUDIO:" + String(AFSK_getAudioLevel()) + " G:" + String(AFSK_getAppliedRxGain()) + "%");
  oled.text(1, 31, "RX VALID:" + String(rfRxCount));
  oled.text(1, 40, "RF>IS:" + String(gatedCount) + " DIGI:" + String(digiTxCount));
  oled.text(1, 49, "SRC:" + clipText(lastRfSource, 14));
  oled.text(1, 58, "DST:" + clipText(lastRfDestination, 14));
}

static void drawOledNetwork() {
  oled.clear(); oledHeader("NETWORK");
  String sta = WiFi.status() == WL_CONNECTED ? WiFi.localIP().toString() : "NO STA";
  oled.text(1, 13, "AP:" + WiFi.softAPIP().toString());
  oled.text(1, 22, "STA:" + clipText(sta, 16));
  oled.text(1, 31, "APRS-IS:" + String(aprsClient.connected() ? "CONNECTED" : "OFFLINE"));
  oled.text(1, 40, "IS>RF:" + String(cfg.isToRfEnabled ? "ON" : "OFF"));
  oled.text(1, 49, "HEAP:" + String(ESP.getFreeHeap()));
  oled.text(1, 58, "UP:" + String(millis()/60000UL) + " MIN");
}

static void drawOledLastPacket() {
  oled.clear(); oledHeader("PACKET RF TERAKHIR");
  oled.text(1, 13, "DARI:" + clipText(lastRfSource, 14));
  oled.text(1, 22, "KE  :" + clipText(lastRfDestination, 14));
  String a = lastRfSummary;
  oled.text(1, 33, clipText(a.substring(0, min((int)a.length(), 20)), 20));
  if (a.length() > 20) oled.text(1, 42, clipText(a.substring(20, min((int)a.length(), 40)), 20));
  if (a.length() > 40) oled.text(1, 51, clipText(a.substring(40, min((int)a.length(), 60)), 20));
}

static String fmt1(float v) { return String(v, 1); }

static void drawOledWeather() {
  oled.clear(); oledHeader("WEATHER RF");
  if (!lastWeather.valid) {
    oled.centered(26, "BELUM ADA DATA", 1);
    oled.centered(39, "WEATHER RF", 1);
    return;
  }
  oled.text(1, 12, "DARI:" + clipText(String(lastWeather.source), 13) + " " + weatherAgeText());
  String l1 = "T:";
  l1 += lastWeather.tempValid ? fmt1(lastWeather.tempC) + "C" : "--";
  l1 += " H:";
  l1 += lastWeather.humidityValid ? String(lastWeather.humidity) + "%" : "--";
  oled.text(1, 23, l1);
  String l2 = "P:";
  l2 += lastWeather.pressureValid ? fmt1(lastWeather.pressureHpa) + "HPA" : "--";
  oled.text(1, 33, l2);
  String l3 = "W:";
  l3 += lastWeather.windDirValid ? String(lastWeather.windDirDeg) : "---";
  l3 += "/";
  l3 += lastWeather.windSpeedValid ? fmt1(lastWeather.windSpeedMph * 0.868976f) + "KT" : "--";
  if (lastWeather.gustValid) l3 += " G" + fmt1(lastWeather.gustMph * 0.868976f);
  oled.text(1, 43, l3);
  String l4 = "RAIN:";
  if (lastWeather.rain1hValid) l4 += fmt1(lastWeather.rain1hMm) + "MM/H";
  else if (lastWeather.rain24hValid) l4 += fmt1(lastWeather.rain24hMm) + "MM/24H";
  else l4 += "--";
  oled.text(1, 53, l4);
}


static double degToRad(double d) { return d * 0.017453292519943295769; }

static float distanceKmBetween(double lat1, double lon1, double lat2, double lon2) {
  const double r = 6371.0088;
  double p1 = degToRad(lat1), p2 = degToRad(lat2);
  double dp = degToRad(lat2 - lat1);
  double dl = degToRad(lon2 - lon1);
  double a = sin(dp * 0.5) * sin(dp * 0.5) +
             cos(p1) * cos(p2) * sin(dl * 0.5) * sin(dl * 0.5);
  a = constrain(a, 0.0, 1.0);
  return (float)(r * 2.0 * atan2(sqrt(a), sqrt(1.0 - a)));
}

static uint16_t bearingDegBetween(double lat1, double lon1, double lat2, double lon2) {
  double p1 = degToRad(lat1), p2 = degToRad(lat2);
  double dl = degToRad(lon2 - lon1);
  double y = sin(dl) * cos(p2);
  double x = cos(p1) * sin(p2) - sin(p1) * cos(p2) * cos(dl);
  double b = atan2(y, x) * 57.295779513082320876;
  if (b < 0.0) b += 360.0;
  int v = (int)lround(b);
  if (v >= 360) v -= 360;
  if (v < 0) v += 360;
  return (uint16_t)v;
}

static bool stationReferencePositionReady() {
  if (cfg.lat < -90.0 || cfg.lat > 90.0 || cfg.lon < -180.0 || cfg.lon > 180.0) return false;
  // 0,0 is the factory default and normally means the station position has
  // not been configured yet. Avoid showing meaningless range/bearing.
  if (fabs(cfg.lat) < 0.000001 && fabs(cfg.lon) < 0.000001) return false;
  return true;
}

static void noteOledHeardPosition(const AX25Msg &msg) {
  if (!stationReferencePositionReady()) return;

  double lat = 0.0, lon = 0.0;
  if (!NusaAprsPosition_parse(msg, lat, lon)) return;

  String call = callToString(msg.src);
  call.trim(); call.toUpperCase();
  if (!call.length() || call.equalsIgnoreCase(stationCall())) return;

  OledHeardPos e;
  e.used = true;
  e.call = call;
  e.lat = lat;
  e.lon = lon;
  e.bearingDeg = bearingDegBetween(cfg.lat, cfg.lon, lat, lon);
  e.distanceKm = distanceKmBetween(cfg.lat, cfg.lon, lat, lon);
  e.whenMs = millis();

  int old = -1;
  for (uint8_t i = 0; i < OLED_HEARD_ROWS; ++i) {
    if (oledHeard[i].used && oledHeard[i].call.equalsIgnoreCase(call)) { old = i; break; }
  }

  if (old >= 0) {
    for (int i = old; i > 0; --i) oledHeard[i] = oledHeard[i - 1];
  } else {
    for (int i = OLED_HEARD_ROWS - 1; i > 0; --i) oledHeard[i] = oledHeard[i - 1];
  }
  oledHeard[0] = e;
}

static void noteOledIsHeardPosition(const IsPacketInfo &p) {
  if (!p.valid || !stationReferencePositionReady()) return;

  // Reuse exactly the same APRS position parser used by the RF heard page.
  // Only the source and information field are needed for position decoding.
  AX25Msg msg{};
  if (!parseCallText(p.src, msg.src)) return;
  size_t n = p.info.length();
  if (n == 0) return;
  if (n > AX25_MAX_INFO_LEN) n = AX25_MAX_INFO_LEN;
  memcpy(msg.info, p.info.c_str(), n);
  msg.len = n;

  double lat = 0.0, lon = 0.0;
  if (!NusaAprsPosition_parse(msg, lat, lon)) return;

  String call = p.src;
  call.trim(); call.toUpperCase();
  if (!call.length() || call.equalsIgnoreCase(stationCall())) return;

  OledHeardPos e;
  e.used = true;
  e.call = call;
  e.lat = lat;
  e.lon = lon;
  e.bearingDeg = bearingDegBetween(cfg.lat, cfg.lon, lat, lon);
  e.distanceKm = distanceKmBetween(cfg.lat, cfg.lon, lat, lon);
  e.whenMs = millis();

  int old = -1;
  for (uint8_t i = 0; i < OLED_HEARD_ROWS; ++i) {
    if (oledIsHeard[i].used && oledIsHeard[i].call.equalsIgnoreCase(call)) { old = i; break; }
  }

  if (old >= 0) {
    for (int i = old; i > 0; --i) oledIsHeard[i] = oledIsHeard[i - 1];
  } else {
    for (int i = OLED_HEARD_ROWS - 1; i > 0; --i) oledIsHeard[i] = oledIsHeard[i - 1];
  }
  oledIsHeard[0] = e;
}

static String oledDistanceText(float km) {
  if (!isfinite(km) || km < 0.0f) return "--";
  if (km < 100.0f) return String(km, 1);
  if (km < 1000.0f) return String((int)lroundf(km));
  if (km < 10000.0f) return String((int)lroundf(km));
  return "9999+";
}

static void drawOledHeardStations() {
  oled.clear();
  oledHeader("TERDENGAR     AZ  KM");

  bool any = false;
  for (uint8_t i = 0; i < OLED_HEARD_ROWS; ++i) {
    if (!oledHeard[i].used) continue;
    any = true;

    String call = clipText(oledHeard[i].call, 9);
    while (call.length() < 9) call += ' ';

    char az[5];
    snprintf(az, sizeof(az), "%03u", (unsigned)oledHeard[i].bearingDeg);
    String d = oledDistanceText(oledHeard[i].distanceKm);
    if (d.length() > 5) d = d.substring(0, 5);
    while (d.length() < 5) d = " " + d;

    // 9 call + 1 + 3 azimuth + 1 + 5 km = 19 characters.
    oled.text(1, 11 + (int)i * 9, call + " " + String(az) + " " + d);
  }

  if (!any) {
    oled.centered(27, stationReferencePositionReady() ? "BELUM ADA POSISI RF" : "SET LAT/LON IGATE", 1);
    oled.centered(39, stationReferencePositionReady() ? "DARI STASIUN" : "DI WEB CONFIG", 1);
  }
}

static void drawOledIsHeardStations() {
  oled.clear();
  oledHeader("VIA IS       AZ  KM");

  bool any = false;
  for (uint8_t i = 0; i < OLED_HEARD_ROWS; ++i) {
    if (!oledIsHeard[i].used) continue;
    any = true;

    String call = clipText(oledIsHeard[i].call, 9);
    while (call.length() < 9) call += ' ';

    char az[5];
    snprintf(az, sizeof(az), "%03u", (unsigned)oledIsHeard[i].bearingDeg);
    String d = oledDistanceText(oledIsHeard[i].distanceKm);
    if (d.length() > 5) d = d.substring(0, 5);
    while (d.length() < 5) d = " " + d;

    oled.text(1, 11 + (int)i * 9, call + " " + String(az) + " " + d);
  }

  if (!any) {
    oled.centered(27, stationReferencePositionReady() ? "BELUM ADA POSISI IS" : "SET LAT/LON IGATE", 1);
    oled.centered(39, stationReferencePositionReady() ? "DARI APRS-IS" : "DI WEB CONFIG", 1);
  }
}

static void drawOledGps() {
  oled.clear();
  oledHeader("GPS TRACKER");
  const NusaGpsData &g = gps.data();
  oled.text(2, 12, gps.statusText(cfg.gpsStaleSec));
  oled.text(2, 21, "SAT " + String(g.satellites) + " HDOP " + String(g.hdop, 1));
  if (gps.fixValid(cfg.gpsStaleSec)) {
    oled.text(2, 30, String(g.lat, 5));
    oled.text(2, 39, String(g.lon, 5));
    String mov = "SPD " + String((int)lroundf(g.speedKmh));
    if (g.courseValid) mov += " CRS " + String((int)lroundf(g.courseDeg));
    oled.text(2, 48, mov);
  } else {
    oled.text(2, 30, "WAITING FOR FIX");
    oled.text(2, 39, "RX " + String(cfg.gpsRxPin) + " " + String(cfg.gpsBaud));
    oled.text(2, 48, "TRK " + String(cfg.trackerEnabled ? "ON" : "OFF"));
  }
  String bot = cfg.trackerBeaconMode == TRACK_MODE_SMART ? "SMART" : "FIXED";
  bot += " NXT " + String(trackerNextSeconds()) + "s";
  oled.text(2, 57, bot);
}

static void initOled() {
  if (!cfg.oledEnabled) { addLog("OLED disabled"); return; }
  if (!oledPinsSafe()) { addLog("OLED disabled: GPIO conflict/invalid"); return; }
  bool ok = oled.begin(cfg.oledSdaPin, cfg.oledSclPin, cfg.oledAddress, cfg.oledContrast, cfg.oledFlip, cfg.oledController);
  if (!ok) { addLog("OLED not detected on 0x3C/0x3D"); return; }
  addLog(String("OLED ") + (cfg.oledController==2 ? "SH1106" : "SSD1306") + " ready I2C=0x" + String(oled.address(), HEX) + " SDA=" + String(cfg.oledSdaPin) + " SCL=" + String(cfg.oledSclPin));
  drawOledLogo();
  oled.display();
}

static void serviceOled() {
  if (!oled.ready()) return;
  uint32_t now = millis();
  if ((uint32_t)(now - oledLastRefreshMs) < 1000U) return;
  oledLastRefreshMs = now;

  // Weather has the highest event priority.
  if ((int32_t)(oledWeatherPopupUntil - now) > 0) { drawOledWeather(); oled.display(); return; }
  if ((int32_t)(oledPacketPopupUntil - now) > 0) { drawOledLastPacket(); oled.display(); return; }

  uint32_t rotateSec = cfg.oledRotateSec < 2 ? 2 : cfg.oledRotateSec;
  uint32_t rotateMs = rotateSec * 1000UL;
  if ((uint32_t)(now - oledLastPageMs) >= rotateMs) {
    oledLastPageMs = now;
    oledPage = (uint8_t)((oledPage + 1) % 8);
  }

  // Skip weather page if no fresh weather.
  bool freshWeather = lastWeather.valid &&
    (uint32_t)(now - lastWeather.whenMs) <= (uint32_t)cfg.oledWeatherMaxAgeMin * 60000UL;
  if (oledPage == 7 && !freshWeather) oledPage = 0;

  if (oledPage == 0) drawOledLogo();
  else if (oledPage == 1) drawOledHome();
  else if (oledPage == 2) drawOledNetwork();
  else if (oledPage == 3) drawOledRf();
  else if (oledPage == 4) drawOledHeardStations();
  else if (oledPage == 5) drawOledIsHeardStations();
  else if (oledPage == 6) drawOledGps();
  else drawOledWeather();
  oled.display();
}

static bool extractAprsMessageToThisStation(const AX25Msg &m, String &body, String &msgId) {
  body = ""; msgId = "";
  if (m.len < 11 || m.info[0] != ':' || m.info[10] != ':') return false;
  String to;
  for (uint8_t i = 1; i <= 9; ++i) to += (char)m.info[i];
  to.trim(); to.toUpperCase();
  if (!to.equalsIgnoreCase(stationCall())) return false;
  for (size_t i = 11; i < m.len; ++i) {
    char c = (char)m.info[i];
    if (c && c != '\r' && c != '\n') body += c;
  }
  body.trim();
  int brace = body.lastIndexOf('{');
  if (brace >= 0) {
    String candidate = body.substring(brace + 1); candidate.trim();
    if (candidate.length() > 0 && candidate.length() <= 5 && candidate.indexOf(' ') < 0) {
      msgId = candidate;
      body = body.substring(0, brace); body.trim();
    }
  }
  return body.length() > 0;
}

static bool buildRfAdminReplyRaw(const String &targetCall, const String &reply, uint8_t *raw, size_t *rawLen) {
  if (!raw || !rawLen) return false;
  AX25Call dst{};
  if (!parseCallText(cfg.dest, dst)) dst = ax25_makeCall("APNU01", 0);
  AX25Call src = ax25_makeCall(cfg.call.c_str(), cfg.ssid);
  AX25Call path[AX25_MAX_RPT]{};
  uint8_t pathCount = parsePath(cfg.rfAdminReplyPath, path);
  String a = normalizeCallSsid(targetCall);
  if (!a.length() || a.length() > 9) return false;
  while (a.length() < 9) a += ' ';
  String info = ":" + a + ":" + reply;
  if (info.length() > AX25_MAX_INFO_LEN) info = info.substring(0, AX25_MAX_INFO_LEN);
  return ax25_buildUI(raw, rawLen, &dst, &src, path, pathCount, 0,
                      (const uint8_t *)info.c_str(), info.length());
}

static bool queueRfAdminReply(const String &targetCall, String reply) {
  reply = singleLine(reply); reply.trim();
  if (reply.length() > 67) reply = reply.substring(0, 67);
  uint8_t raw[AX25_MAX_FRAME_LEN]; size_t len = 0;
  if (!buildRfAdminReplyRaw(targetCall, reply, raw, &len)) return false;
  if (!queueRf(raw, len, TX_REMOTE_ADMIN, 150)) return false;
  ++rfAdminReplyCount;
  return true;
}

static String rfAdminGetText() {
  String s = "D=" + String(effectiveDigiEnabled() ? 1 : 0) +
             " I=" + String(effectiveIgateEnabled() ? 1 : 0) +
             " A=" + String(cfg.autoModeSwitchEnabled ? 1 : 0) +
             " R=" + String(cfg.isToRfEnabled ? 1 : 0) +
             " Q=" + String(cfg.rxSquelch) +
             " G=" + String(cfg.rxDecoderGain) +
             " T=" + String(cfg.txLevel) +
             " B=" + String(cfg.beaconSec);
  if (rfAdminDirty) s += " *";
  return s;
}

static String rfAdminStatText() {
  uint32_t upMin = millis() / 60000UL;
  String up = upMin >= 1440UL ? String(upMin / 1440UL) + "D" : String(upMin / 60UL) + "H";
  String s = "UP=" + up + " RX=" + String(rfRxCount) +
             " D=" + String(effectiveDigiEnabled() ? 1 : 0) +
             " I=" + String(effectiveIgateEnabled() ? 1 : 0) +
             " A=" + String(cfg.autoModeSwitchEnabled ? 1 : 0) +
             " IS=" + String(aprsClient.connected() ? 1 : 0) +
             " H=" + String(ESP.getFreeHeap() / 1024UL) + "K";
  return s;
}

static bool setRemoteOnOff(String arg, bool &field) {
  bool v = false;
  if (!parseOnOff(arg, v)) return false;
  field = v; rfAdminDirty = true; return true;
}

static void applyRemoteOledState(bool previous) {
  if (previous && !cfg.oledEnabled && oled.ready()) oled.end();
  if (!previous && cfg.oledEnabled && !oled.ready()) initOled();
}

static bool processRfAdminMessage(const AX25Msg &m) {
  String cmd, msgId;
  if (!extractAprsMessageToThisStation(m, cmd, msgId)) return false;
  if (!cfg.rfAdminEnabled) return false;

  String src = callToString(m.src); src.toUpperCase();
  if (!rfAdminIsAuthorized(m.src)) {
    ++rfAdminDeniedCount;
    addLog("RF ADMIN DENIED SRC=" + src + " (silent)");
    return true; // consumed as a local admin attempt; intentionally no RF reply
  }

  ++rfAdminOkCount;
  // If the admin client attached a standard APRS message number, acknowledge
  // it so normal APRS apps/radios stop retrying. Non-admin never reaches here.
  if (msgId.length()) queueRfAdminReply(src, "ack" + msgId);

  String original = cmd;
  String upper = cmd; upper.toUpperCase(); upper.trim();
  int sp = upper.indexOf(' ');
  String op = sp < 0 ? upper : upper.substring(0, sp);
  String arg = sp < 0 ? String("") : original.substring(sp + 1);
  arg.trim();
  String uarg = arg; uarg.toUpperCase();
  String reply;

  if (op == "STAT") reply = rfAdminStatText();
  else if (op == "GET") reply = rfAdminGetText();
  else if (op == "DIGI") {
    if (cfg.autoModeSwitchEnabled) reply = "ERR AUTO";
    else if (!setRemoteOnOff(uarg, cfg.digiEnabled)) reply = "ERR VALUE";
    else reply = "OK DIGI " + String(cfg.digiEnabled ? "ON" : "OFF") + remoteDirtySuffix();
  } else if (op == "IGATE") {
    if (cfg.autoModeSwitchEnabled) reply = "ERR AUTO";
    else if (!setRemoteOnOff(uarg, cfg.igateEnabled)) reply = "ERR VALUE";
    else reply = "OK IGATE " + String(cfg.igateEnabled ? "ON" : "OFF") + remoteDirtySuffix();
  } else if (op == "AMODE" || op == "AUTO") {
    if (!setRemoteOnOff(uarg, cfg.autoModeSwitchEnabled)) reply = "ERR VALUE";
    else { autoModeLast = -1; serviceAutoModeSwitch(); reply = "OK AMODE " + String(cfg.autoModeSwitchEnabled ? "ON" : "OFF") + remoteDirtySuffix(); }
  } else if (op == "ISRF") {
    if (!setRemoteOnOff(uarg, cfg.isToRfEnabled)) reply = "ERR VALUE";
    else reply = "OK ISRF " + String(cfg.isToRfEnabled ? "ON" : "OFF") + remoteDirtySuffix();
  } else if (op == "RFBCN") {
    if (!setRemoteOnOff(uarg, cfg.rfBeaconEnabled)) reply = "ERR VALUE";
    else reply = "OK RFBCN " + String(cfg.rfBeaconEnabled ? "ON" : "OFF") + remoteDirtySuffix();
  } else if (op == "ISBCN") {
    if (!setRemoteOnOff(uarg, cfg.isBeaconEnabled)) reply = "ERR VALUE";
    else reply = "OK ISBCN " + String(cfg.isBeaconEnabled ? "ON" : "OFF") + remoteDirtySuffix();
  } else if (op == "RXSQL") {
    int v = arg.toInt();
    if (!digitsOnly(arg) || v < 5 || v > 1000) reply = "ERR VALUE";
    else { cfg.rxSquelch = (uint16_t)v; applyModemConfig(); rfAdminDirty = true; reply = "OK RXSQL " + String(v) + remoteDirtySuffix(); }
  } else if (op == "RXGAIN") {
    int v = arg.toInt();
    if (!digitsOnly(arg) || !((v == 0) || (v >= 20 && v <= 500))) reply = "ERR VALUE";
    else { cfg.rxDecoderGain = (uint16_t)v; applyModemConfig(); rfAdminDirty = true; reply = "OK RXGAIN " + String(v) + remoteDirtySuffix(); }
  } else if (op == "TXLVL") {
    int v = arg.toInt();
    if (!digitsOnly(arg) || v < 10 || v > 100) reply = "ERR VALUE";
    else { cfg.txLevel = (uint8_t)v; applyModemConfig(); rfAdminDirty = true; reply = "OK TXLVL " + String(v) + remoteDirtySuffix(); }
  } else if (op == "BSEC") {
    long v = arg.toInt();
    if (!digitsOnly(arg) || v < 30 || v > 86400) reply = "ERR VALUE";
    else { cfg.beaconSec = (uint32_t)v; rfAdminDirty = true; reply = "OK BSEC " + String(v) + remoteDirtySuffix(); }
  } else if (op == "DDELAY") {
    int v = arg.toInt();
    if (!digitsOnly(arg) || v < 0 || v > 3000) reply = "ERR VALUE";
    else { cfg.digiDelayMs = (uint16_t)v; rfAdminDirty = true; reply = "OK DDELAY " + String(v) + remoteDirtySuffix(); }
  } else if (op == "DUPSEC") {
    int v = arg.toInt();
    if (!digitsOnly(arg) || v < 5 || v > 300) reply = "ERR VALUE";
    else { cfg.duplicateSec = (uint16_t)v; rfAdminDirty = true; reply = "OK DUPSEC " + String(v) + remoteDirtySuffix(); }
  } else if (op == "FILTER") {
    String f = uarg; f.toLowerCase();
    if (!parseLocalIsRfFilter(f).valid) reply = "ERR FILTER";
    else { cfg.localIsRfFilter = f; rfAdminDirty = true; reply = "OK FILTER " + f + remoteDirtySuffix(); }
  } else if (op == "ALIAS") {
    String v = uarg; v.trim();
    if (!v.length() || v.length() > 40) reply = "ERR VALUE";
    else { cfg.digiAliases = v; rfAdminDirty = true; reply = "OK ALIAS" + remoteDirtySuffix(); }
  } else if (op == "RFPATH" || op == "ISPATH") {
    String v = uarg; v.trim();
    if (v == "DIRECT") v = "";
    if (!validPathText(v)) reply = "ERR PATH";
    else {
      if (op == "RFPATH") cfg.rfPath = v; else cfg.isToRfPath = v;
      rfAdminDirty = true;
      reply = "OK " + op + " " + (v.length() ? v : String("DIRECT")) + remoteDirtySuffix();
    }
  } else if (op == "COMMENT") {
    String v = singleLine(arg); v.trim();
    if (v.length() > 100) v = v.substring(0, 100);
    cfg.comment = v; rfAdminDirty = true; reply = "OK COMMENT" + remoteDirtySuffix();
  } else if (op == "TRK") {
    if (!setRemoteOnOff(uarg, cfg.trackerEnabled)) reply = "ERR VALUE";
    else reply = "OK TRK " + String(cfg.trackerEnabled ? "ON" : "OFF") + remoteDirtySuffix();
  } else if (op == "GPS") {
    const NusaGpsData &g = gps.data();
    bool fix = gps.fixValid(cfg.gpsStaleSec);
    reply = "FIX=" + String(fix ? 1 : 0) + " SAT=" + String(g.satellites);
    if (fix) {
      reply += " SPD=" + String((int)lroundf(g.speedKmh));
      reply += " CRS=" + String(g.courseValid ? (int)lroundf(g.courseDeg) : 0);
    }
  } else if (op == "TMODE") {
    if (uarg == "FIX" || uarg == "FIXED") cfg.trackerBeaconMode = TRACK_MODE_FIXED;
    else if (uarg == "SMART") cfg.trackerBeaconMode = TRACK_MODE_SMART;
    else { reply = "ERR VALUE"; goto rfadmin_done; }
    rfAdminDirty = true;
    reply = "OK TMODE " + String(cfg.trackerBeaconMode == TRACK_MODE_SMART ? "SMART" : "FIX") + remoteDirtySuffix();
  } else if (op == "TSEC") {
    int v = arg.toInt();
    if (!digitsOnly(arg) || v < 30 || v > 3600) reply = "ERR VALUE";
    else { cfg.trackerFixedSec = (uint16_t)v; rfAdminDirty = true; reply = "OK TSEC " + String(v) + remoteDirtySuffix(); }
  } else if (op == "TPATH") {
    String v = uarg; v.trim();
    if (v == "DIRECT") v = "";
    if (!validPathText(v)) reply = "ERR PATH";
    else { cfg.trackerRfPath = v; rfAdminDirty = true; reply = "OK TPATH " + (v.length() ? v : String("DIRECT")) + remoteDirtySuffix(); }
  } else if (op == "TOUT") {
    if (uarg == "RF") cfg.trackerOutput = TRACK_OUT_RF;
    else if (uarg == "IS") cfg.trackerOutput = TRACK_OUT_IS;
    else if (uarg == "BOTH") cfg.trackerOutput = TRACK_OUT_BOTH;
    else { reply = "ERR VALUE"; goto rfadmin_done; }
    rfAdminDirty = true;
    reply = "OK TOUT " + uarg + remoteDirtySuffix();
  } else if (op == "TBCN") {
    reply = sendTrackerBeacon(true, "ADMIN") ? "OK TBCN" : "ERR NOFIX";
  } else if (op == "OLED") {
    bool old = cfg.oledEnabled;
    if (!setRemoteOnOff(uarg, cfg.oledEnabled)) reply = "ERR VALUE";
    else { applyRemoteOledState(old); reply = "OK OLED " + String(cfg.oledEnabled ? "ON" : "OFF") + remoteDirtySuffix(); }
  } else if (op == "SAVE") {
    persistRfAdminOperationalConfig();
    reply = "OK SAVED";
  } else if (op == "CANCEL") {
    restoreRfAdminSavedConfig();
    reply = "OK CANCEL";
  } else if (op == "REBOOT") {
    reply = "OK REBOOT";
    rfAdminRebootPending = true;
    rfAdminRebootRequestedMs = millis();
  } else {
    reply = "ERR CMD";
  }

rfadmin_done:
  addLog("RF ADMIN " + src + " CMD=" + upper + " -> " + reply);
  queueRfAdminReply(src, reply);
  return true;
}

static void serviceRfAdmin() {
  if (!rfAdminRebootPending) return;
  // Cooperative/non-blocking reboot: give the queued APRS reply time to TX.
  uint32_t age = millis() - rfAdminRebootRequestedMs;
  if (age < 1200UL) return;
  if ((txHead == txTail && !AFSK_isTransmitting()) || age > 10000UL) {
    rfAdminRebootPending = false;
    ESP.restart();
  }
}

static void onAx25Frame(AX25Msg *msg) {
  if (!msg) return;
  ++rfRxCount;
  String tnc = msgToTnc2(*msg);
  uint8_t dec = AFSK_getLastReadDecoder();
  String decName;
  if (dec == 1) decName = "A";
  else if (dec == 2) decName = "B-RAW";
  else if (dec == 3) decName = "B-EQ125";
  else if (dec == 4) decName = "B-EQ130";
  else decName = "?";
  addLog("RF RX [DEC-" + decName + "] " + tnc);

  lastRfSource = callToString(msg->src);
  lastRfDestination = callToString(msg->dst);
  lastRfSummary = "";
  for (size_t i = 0; i < msg->len && lastRfSummary.length() < 90; ++i) {
    char c = (char)msg->info[i];
    if (c && c != '\r' && c != '\n') lastRfSummary += c;
  }
  lastRfEventMs = millis();
  if (cfg.oledEnabled && oled.ready()) oledPacketPopupUntil = millis() + 3000UL;

  // Update the six-row local-station OLED page only when the RF packet
  // contains a valid APRS position.
  noteOledHeardPosition(*msg);

  NusaWeatherData wx;
  if (NusaWeather_parse(*msg, wx)) {
    lastWeather = wx;
    addLog("WEATHER RF < " + String(lastWeather.source) +
           (lastWeather.tempValid ? " T=" + String(lastWeather.tempC,1) + "C" : "") +
           (lastWeather.humidityValid ? " H=" + String(lastWeather.humidity) + "%" : ""));
    if (cfg.oledEnabled && oled.ready()) oledWeatherPopupUntil = millis() + (uint32_t)cfg.oledPopupSec * 1000UL;
  }

  // Learn RF reachability before any iGate/digipeater processing.  A packet
  // with no used repeater H bits is hop 0 and qualifies for i/30/0.
  noteRfHeard(*msg);

  gateToAprsIs(*msg);
  maybeDigipeat(*msg);

  // Additive RF Remote Admin runs after the legacy iGate/digipeater path so
  // existing forwarding/queue order remains unchanged. Non-admin gets no reply.
  processRfAdminMessage(*msg);
}


static bool staticPositionValid() {
  if (!isfinite(cfg.lat) || !isfinite(cfg.lon)) return false;
  if (cfg.lat < -90.0 || cfg.lat > 90.0 || cfg.lon < -180.0 || cfg.lon > 180.0) return false;
  // REV1S defaults are 0,0. Treat that untouched default as "not configured"
  // so AUTO fallback never emits an accidental Gulf of Guinea position.
  return fabs(cfg.lat) > 0.000001 || fabs(cfg.lon) > 0.000001;
}

static bool gpsPinConflicts(int pin) {
  if (pin < 0) return false;
  if (pin == 36 || pin == 26) return true; // frozen APRS RX ADC / TX DAC
  if (pin == cfg.pttPin || pin == cfg.rxLedPin || pin == cfg.txLedPin) return true;
  if (cfg.oledEnabled && (pin == cfg.oledSdaPin || pin == cfg.oledSclPin)) return true;
  return false;
}

static bool gpsPinsSafe() {
  if (cfg.gpsRxPin < 0 || cfg.gpsRxPin > 39) return false;
  if (cfg.gpsTxPin < -1 || cfg.gpsTxPin > 33) return false; // GPIO34..39 are input-only
  if (cfg.gpsTxPin >= 0 && cfg.gpsTxPin == cfg.gpsRxPin) return false;
  if (gpsPinConflicts(cfg.gpsRxPin) || gpsPinConflicts(cfg.gpsTxPin)) return false;
  return true;
}

static void initGps() {
  if (!gpsPinsSafe()) {
    gps.end();
    addLog("GPS disabled: GPIO conflict/invalid");
    return;
  }
  gps.begin(cfg.gpsRxPin, cfg.gpsTxPin, cfg.gpsBaud);
  addLog("GPS UART started RX=GPIO" + String(cfg.gpsRxPin) +
         " TX=" + (cfg.gpsTxPin >= 0 ? String("GPIO") + String(cfg.gpsTxPin) : String("OFF")) +
         " " + String(cfg.gpsBaud) + " baud");
}

static bool getTrackerPosition(TrackerPosition &p) {
  p = TrackerPosition();
  bool gpsOk = gps.fixValid(cfg.gpsStaleSec);
  if (cfg.trackerPositionMode == TRACK_POS_GPS && !gpsOk) return false;

  if ((cfg.trackerPositionMode == TRACK_POS_GPS || cfg.trackerPositionMode == TRACK_POS_AUTO) && gpsOk) {
    const NusaGpsData &g = gps.data();
    p.valid = true;
    p.fromGps = true;
    p.lat = g.lat;
    p.lon = g.lon;
    p.speedKmh = g.speedKmh;
    p.courseDeg = g.courseDeg;
    p.altitudeM = g.altitudeM;
    p.courseValid = g.courseValid;
    p.altitudeValid = g.altitudeValid;
    return true;
  }

  if ((cfg.trackerPositionMode == TRACK_POS_STATIC || cfg.trackerPositionMode == TRACK_POS_AUTO) && staticPositionValid()) {
    p.valid = true;
    p.lat = cfg.lat;
    p.lon = cfg.lon;
    return true;
  }
  return false;
}

static void normalizeAprsDegrees(double value, bool latitude, int &deg, double &minutes, char &hemi) {
  hemi = value >= 0.0 ? (latitude ? 'N' : 'E') : (latitude ? 'S' : 'W');
  double a = fabs(value);
  deg = (int)a;
  minutes = (a - deg) * 60.0;
  minutes = floor(minutes * 100.0 + 0.5) / 100.0;
  if (minutes >= 60.0) { minutes = 0.0; ++deg; }
}

static String trackerPositionPayload(TrackerPosition *used = nullptr) {
  TrackerPosition p;
  if (!getTrackerPosition(p)) return "";
  if (used) *used = p;

  int latDeg = 0, lonDeg = 0;
  double latMin = 0.0, lonMin = 0.0;
  char ns = 'N', ew = 'E';
  normalizeAprsDegrees(p.lat, true, latDeg, latMin, ns);
  normalizeAprsDegrees(p.lon, false, lonDeg, lonMin, ew);

  char b[96];
  snprintf(b, sizeof(b), "!%02d%05.2f%c%c%03d%05.2f%c%c",
           latDeg, latMin, ns, cfg.trackerSymbolTable,
           lonDeg, lonMin, ew, cfg.trackerSymbolCode);
  String payload(b);

  if (p.fromGps && p.courseValid && p.speedKmh > (float)cfg.stationarySpeedKmh) {
    int course = (int)lroundf(p.courseDeg);
    if (course <= 0) course = 360;
    if (course > 360) course = 360;
    int knots = (int)lroundf(p.speedKmh / 1.852f);
    knots = constrain(knots, 0, 999);
    char cs[12];
    snprintf(cs, sizeof(cs), "%03d/%03d", course, knots);
    payload += cs;
  }

  if (p.fromGps && p.altitudeValid) {
    long feet = lroundf(p.altitudeM * 3.28084f);
    if (feet >= 0 && feet <= 999999L) {
      char alt[16];
      snprintf(alt, sizeof(alt), "/A=%06ld", feet);
      payload += alt;
    }
  }

  if (cfg.trackerComment.length()) {
    payload += " ";
    payload += cfg.trackerComment;
  }
  return payload;
}

static bool buildTrackerRaw(uint8_t *raw, size_t *rawLen, String &payload) {
  if (!raw || !rawLen || sanitizeBaseCall(cfg.call) == "NOCALL") return false;
  payload = trackerPositionPayload();
  if (!payload.length()) return false;
  AX25Call src = ax25_makeCall(cfg.call.c_str(), cfg.ssid);
  AX25Call dst{};
  if (!parseCallText(cfg.dest, dst)) dst = ax25_makeCall("APZUAG", 0);
  AX25Call path[AX25_MAX_RPT]{};
  uint8_t pathCount = parsePath(cfg.trackerRfPath, path);
  return ax25_buildUI(raw, rawLen, &dst, &src, path, pathCount, 0,
                      (const uint8_t *)payload.c_str(), payload.length());
}

static bool sendTrackerBeacon(bool manual, const char *reason) {
  if (sanitizeBaseCall(cfg.call) == "NOCALL") return false;
  if (!manual && lastTrackerBeaconMs &&
      (uint32_t)(millis() - lastTrackerBeaconMs) < (uint32_t)cfg.trackerMinTxSec * 1000UL) return false;

  TrackerPosition pos;
  String payload = trackerPositionPayload(&pos);
  if (!payload.length() || !pos.valid) return false;
  if (!manual) lastTrackerAttemptMs = millis();

  bool any = false;
  if (cfg.trackerOutput == TRACK_OUT_RF || cfg.trackerOutput == TRACK_OUT_BOTH) {
    uint8_t raw[AX25_MAX_FRAME_LEN];
    size_t len = 0;
    String rfPayload;
    if (buildTrackerRaw(raw, &len, rfPayload) && queueRf(raw, len, TX_TRACKER, 0)) {
      any = true;
      addLog("TRK RF QUEUED " + String(reason ? reason : "AUTO"));
    } else {
      ++trackerDroppedTxCount;
      addLog("TRK RF DROP queue/build");
    }
  }

  if (cfg.trackerOutput == TRACK_OUT_IS || cfg.trackerOutput == TRACK_OUT_BOTH) {
    if (aprsClient.connected()) {
      String line = stationCall() + ">" + cfg.dest + ",TCPIP*:" + payload + "\r\n";
      aprsClient.print(line);
      ++trackerIsBeaconCount;
      any = true;
      addLog("TRK IS TX " + String(reason ? reason : "AUTO"));
    } else {
      addLog("TRK IS SKIP: APRS-IS disconnected");
    }
  }

  if (any) {
    lastTrackerBeaconMs = millis();
    lastTrackerReason = reason ? String(reason) : String("AUTO");
    if (pos.fromGps && pos.courseValid && pos.speedKmh > (float)cfg.stationarySpeedKmh) {
      lastTrackerCourseDeg = pos.courseDeg;
      lastTrackerCourseValid = true;
    }
  }
  return any;
}

static float headingDelta(float a, float b) {
  float d = fabsf(a - b);
  while (d >= 360.0f) d -= 360.0f;
  return d > 180.0f ? 360.0f - d : d;
}

static uint32_t smartBeaconIntervalSec(float speedKmh) {
  if (speedKmh <= (float)cfg.stationarySpeedKmh || speedKmh <= (float)cfg.smartSlowSpeedKmh)
    return cfg.smartSlowRateSec;
  if (speedKmh >= (float)cfg.smartFastSpeedKmh)
    return cfg.smartFastRateSec;
  uint32_t sec = (uint32_t)lroundf((float)cfg.smartFastRateSec *
                                   (float)cfg.smartFastSpeedKmh / speedKmh);
  if (sec < cfg.smartFastRateSec) sec = cfg.smartFastRateSec;
  if (sec > cfg.smartSlowRateSec) sec = cfg.smartSlowRateSec;
  return sec;
}

static uint32_t trackerNextSeconds() {
  if (!cfg.trackerEnabled) return 0;
  TrackerPosition p;
  if (!getTrackerPosition(p)) return 0;
  uint32_t target = cfg.trackerBeaconMode == TRACK_MODE_SMART ?
                    smartBeaconIntervalSec(p.speedKmh) : cfg.trackerFixedSec;
  if (!lastTrackerBeaconMs) return 0;
  uint32_t elapsed = (uint32_t)(millis() - lastTrackerBeaconMs) / 1000UL;
  return elapsed >= target ? 0 : target - elapsed;
}

static void serviceTracker() {
  bool connected = gps.connected();
  bool fix = gps.fixValid(cfg.gpsStaleSec);
  if (connected != lastGpsConnectedState) {
    if (connected) addLog("GPS CONNECTED");
    else if (lastGpsConnectedState) addLog("GPS LOST");
    lastGpsConnectedState = connected;
  }
  if (fix != lastGpsFixState) {
    if (fix) {
      addLog(gpsHadFixPreviously ? "GPS RESTORED" : "GPS FIX");
      gpsHadFixPreviously = true;
    } else if (lastGpsFixState) {
      addLog(gps.stale(cfg.gpsStaleSec) ? "GPS STALE" : "GPS LOST");
    }
    lastGpsFixState = fix;
  }

  if (!cfg.trackerEnabled) return;
  TrackerPosition p;
  if (!getTrackerPosition(p)) return;

  if (!lastTrackerBeaconMs) {
    sendTrackerBeacon(false, "START");
    return;
  }

  uint32_t elapsedSec = (uint32_t)(millis() - lastTrackerBeaconMs) / 1000UL;
  if (elapsedSec < cfg.trackerMinTxSec) return;
  if (lastTrackerAttemptMs && (uint32_t)(millis() - lastTrackerAttemptMs) < (uint32_t)cfg.trackerMinTxSec * 1000UL) return;

  if (cfg.trackerBeaconMode == TRACK_MODE_FIXED) {
    if (elapsedSec >= cfg.trackerFixedSec) sendTrackerBeacon(false, "FIXED");
    return;
  }

  if (p.fromGps && p.courseValid && lastTrackerCourseValid &&
      p.speedKmh > (float)cfg.stationarySpeedKmh &&
      elapsedSec >= cfg.smartTurnTimeSec) {
    float mph = p.speedKmh * 0.621371f;
    if (mph < 1.0f) mph = 1.0f;
    float threshold = (float)cfg.smartTurnAngleDeg + (float)cfg.smartTurnSlope / mph;
    if (threshold > 180.0f) threshold = 180.0f;
    if (headingDelta(p.courseDeg, lastTrackerCourseDeg) >= threshold) {
      if (sendTrackerBeacon(false, "TURN")) ++trackerSmartTurnCount;
      return;
    }
  }

  uint32_t interval = smartBeaconIntervalSec(p.speedKmh);
  if (elapsedSec >= interval) {
    if (sendTrackerBeacon(false, p.speedKmh <= (float)cfg.stationarySpeedKmh ? "SLOW" : "SPEED"))
      ++trackerSmartSpeedCount;
  }
}

static String aprsPositionPayload() {
  double alat = fabs(cfg.lat), alon = fabs(cfg.lon);
  int latDeg = (int)alat;
  int lonDeg = (int)alon;
  double latMin = (alat - latDeg) * 60.0;
  double lonMin = (alon - lonDeg) * 60.0;
  char b[128];
  char ns = cfg.lat >= 0 ? 'N' : 'S';
  char ew = cfg.lon >= 0 ? 'E' : 'W';
  snprintf(b, sizeof(b), "!%02d%05.2f%c%c%03d%05.2f%c%c",
           latDeg, latMin, ns, cfg.symbolTable,
           lonDeg, lonMin, ew, cfg.symbolCode);
  String s(b);
  if (cfg.comment.length()) s += cfg.comment;
  return s;
}

static bool buildBeaconRaw(uint8_t *raw, size_t *rawLen) {
  if (!raw || !rawLen || sanitizeBaseCall(cfg.call) == "NOCALL") return false;
  AX25Call src = ax25_makeCall(cfg.call.c_str(), cfg.ssid);
  AX25Call dst{};
  if (!parseCallText(cfg.dest, dst)) dst = ax25_makeCall("APNU01", 0);
  AX25Call path[AX25_MAX_RPT]{};
  uint8_t pathCount = parsePath(cfg.rfPath, path);
  String payload = aprsPositionPayload();
  return ax25_buildUI(raw, rawLen, &dst, &src, path, pathCount, 0,
                      (const uint8_t *)payload.c_str(), payload.length());
}

static void sendRfBeacon() {
  uint8_t raw[AX25_MAX_FRAME_LEN];
  size_t len = 0;
  if (!buildBeaconRaw(raw, &len)) {
    addLog("RF beacon skipped: invalid callsign/config");
    return;
  }
  if (queueRf(raw, len, TX_BEACON, 0)) addLog("RF beacon queued");
}

static void sendIsBeacon() {
  // Automatic scheduling is controlled by cfg.isBeaconEnabled in loop().
  // Keeping this function independent allows the WEB "BEACON IS NOW" button
  // to work even when automatic APRS-IS beaconing is disabled.
  if (!aprsClient.connected() || sanitizeBaseCall(cfg.call) == "NOCALL") return;
  String line = stationCall() + ">" + cfg.dest + ",TCPIP*:" + aprsPositionPayload() + "\r\n";
  aprsClient.print(line);
  ++isBeaconCount;
  addLog("BEACON > IS  " + line.substring(0, line.length() - 2));
}

static void serviceRfTx() {
  if (txHead == txTail || AFSK_isTransmitting()) return;
  TxJob &j = txQueue[txHead];
  uint32_t now = millis();
  if (!timeReached(now, j.due)) return;

  if (AFSK_channelBusy()) {
    if ((uint32_t)(now - j.queued) > 5000U) {
      addLog("RF TX dropped: channel busy >5s");
      ++droppedTxCount;
      if (j.kind == TX_IS_TO_RF) ++isToRfDropCount;
      if (j.kind == TX_TRACKER) ++trackerDroppedTxCount;
      txHead = (uint8_t)((txHead + 1) % TX_QUEUE_SIZE);
    }
    return;
  }

  if (j.kind == TX_IS_TO_RF && !isToRfRateAllowed()) {
    addLog("IS>RF DROP rate limit (6/min, 10/5min)");
    ++isToRfDropCount;
    txHead = (uint8_t)((txHead + 1) % TX_QUEUE_SIZE);
    return;
  }

  if (j.kind == TX_DIGI) addLog("RF TX DIGI");
  else if (j.kind == TX_IS_TO_RF) addLog("RF TX IS>RF MESSAGE");
  else if (j.kind == TX_REMOTE_ADMIN) addLog("RF TX ADMIN REPLY");
  else if (j.kind == TX_TRACKER) addLog("TRK RF TX");
  else addLog("RF TX BEACON");

  AFSK_transmit((char *)j.data, j.len);
  if (j.kind == TX_DIGI) ++digiTxCount;
  else if (j.kind == TX_IS_TO_RF) { ++isToRfTxCount; noteIsToRfTxNow(); }
  else if (j.kind == TX_REMOTE_ADMIN) { /* counted when queued */ }
  else if (j.kind == TX_TRACKER) ++trackerRfBeaconCount;
  else ++rfBeaconCount;
  txHead = (uint8_t)((txHead + 1) % TX_QUEUE_SIZE);
}

static void loadConfig() {
  prefs.begin("nusaaprs", true);
  cfg.call = prefs.getString("call", cfg.call);
  cfg.ssid = prefs.getUChar("ssid", cfg.ssid);
  cfg.dest = prefs.getString("dest", cfg.dest);
  cfg.wifiSsid = prefs.getString("wssid", cfg.wifiSsid);
  cfg.wifiPass = prefs.getString("wpass", cfg.wifiPass);
  cfg.apSsid = prefs.getString("apssid", cfg.apSsid);
  cfg.apPass = prefs.getString("appass", cfg.apPass);
  cfg.isServer = prefs.getString("server", cfg.isServer);
  cfg.isPort = prefs.getUShort("port", cfg.isPort);
  cfg.isPasscode = prefs.getInt("ispass", cfg.isPasscode);
  cfg.isFilter = prefs.getString("filter", cfg.isFilter);
  cfg.igateEnabled = prefs.getBool("igate", cfg.igateEnabled);
  cfg.autoModeSwitchEnabled = prefs.getBool("automode", cfg.autoModeSwitchEnabled);
  cfg.isToRfEnabled = prefs.getBool("is2rf", cfg.isToRfEnabled);
  cfg.localIsRfFilter = prefs.getString("isrfflt", cfg.localIsRfFilter);
  cfg.isToRfPath = prefs.getString("isrfpath", cfg.isToRfPath);
  cfg.digiEnabled = prefs.getBool("digi", cfg.digiEnabled);
  cfg.digiAliases = prefs.getString("alias", cfg.digiAliases);
  cfg.digiDelayMs = prefs.getUShort("ddelay", cfg.digiDelayMs);
  cfg.duplicateSec = prefs.getUShort("dupsec", cfg.duplicateSec);
  cfg.rfBeaconEnabled = prefs.getBool("rfbcn", cfg.rfBeaconEnabled);
  cfg.isBeaconEnabled = prefs.getBool("isbcn", cfg.isBeaconEnabled);
  cfg.beaconSec = prefs.getUInt("bsec", cfg.beaconSec);
  cfg.lat = prefs.getDouble("lat", cfg.lat);
  cfg.lon = prefs.getDouble("lon", cfg.lon);
  String st = prefs.getString("symtbl", String(cfg.symbolTable)); if (st.length()) cfg.symbolTable = st[0];
  String sc = prefs.getString("sym", String(cfg.symbolCode)); if (sc.length()) cfg.symbolCode = sc[0];
  cfg.comment = prefs.getString("comment", cfg.comment);
  cfg.rfPath = prefs.getString("path", cfg.rfPath);
  cfg.trackerEnabled = prefs.getBool("trken", cfg.trackerEnabled);
  cfg.trackerPositionMode = prefs.getUChar("posmode", cfg.trackerPositionMode);
  cfg.gpsRxPin = prefs.getInt("gpsrx", cfg.gpsRxPin);
  cfg.gpsTxPin = prefs.getInt("gpstx", cfg.gpsTxPin);
  cfg.gpsBaud = prefs.getUInt("gpsbaud", cfg.gpsBaud);
  cfg.gpsStaleSec = prefs.getUShort("gpsstale", cfg.gpsStaleSec);
  cfg.trackerOutput = prefs.getUChar("trout", cfg.trackerOutput);
  cfg.trackerRfPath = prefs.getString("trpath", cfg.trackerRfPath);
  String tst = prefs.getString("trsymt", String(cfg.trackerSymbolTable)); if (tst.length()) cfg.trackerSymbolTable = tst[0];
  String tsc = prefs.getString("trsym", String(cfg.trackerSymbolCode)); if (tsc.length()) cfg.trackerSymbolCode = tsc[0];
  cfg.trackerComment = prefs.getString("trcomm", cfg.trackerComment);
  cfg.trackerBeaconMode = prefs.getUChar("trmode", cfg.trackerBeaconMode);
  cfg.trackerFixedSec = prefs.getUShort("trsec", cfg.trackerFixedSec);
  cfg.smartSlowSpeedKmh = prefs.getUShort("sslow", cfg.smartSlowSpeedKmh);
  cfg.smartSlowRateSec = prefs.getUShort("srslow", cfg.smartSlowRateSec);
  cfg.smartFastSpeedKmh = prefs.getUShort("sfast", cfg.smartFastSpeedKmh);
  cfg.smartFastRateSec = prefs.getUShort("srfast", cfg.smartFastRateSec);
  cfg.smartTurnAngleDeg = prefs.getUShort("sturn", cfg.smartTurnAngleDeg);
  cfg.smartTurnSlope = prefs.getUShort("sslope", cfg.smartTurnSlope);
  cfg.smartTurnTimeSec = prefs.getUShort("sturnt", cfg.smartTurnTimeSec);
  cfg.stationarySpeedKmh = prefs.getUShort("sstat", cfg.stationarySpeedKmh);
  cfg.trackerMinTxSec = prefs.getUShort("trmin", cfg.trackerMinTxSec);
  cfg.preambleMs = prefs.getUShort("pre", cfg.preambleMs);
  cfg.tailMs = prefs.getUShort("tail", cfg.tailMs);
  cfg.txLevel = prefs.getUChar("txlvl", cfg.txLevel);
  cfg.rxSquelch = prefs.getUShort("rxsql", cfg.rxSquelch);
  cfg.rxDecoderGain = prefs.getUShort("rxgain", cfg.rxDecoderGain);
  uint8_t audioTuneRev = prefs.getUChar("audrev", 0);
  cfg.pttPin = prefs.getInt("pttpin", cfg.pttPin);
  cfg.pttActiveHigh = prefs.getBool("ptthi", cfg.pttActiveHigh);
  cfg.rxLedPin = prefs.getInt("rxled", cfg.rxLedPin);
  cfg.txLedPin = prefs.getInt("txled", cfg.txLedPin);
  cfg.oledEnabled = prefs.getBool("oled", cfg.oledEnabled);
  cfg.oledSdaPin = prefs.getInt("osda", cfg.oledSdaPin);
  cfg.oledSclPin = prefs.getInt("oscl", cfg.oledSclPin);
  cfg.oledAddress = prefs.getUChar("oaddr", cfg.oledAddress);
  cfg.oledController = prefs.getUChar("octrl", cfg.oledController);
  if (cfg.oledController != 1 && cfg.oledController != 2) cfg.oledController = 2;
  cfg.oledContrast = prefs.getUChar("ocon", cfg.oledContrast);
  cfg.oledFlip = prefs.getBool("oflip", cfg.oledFlip);
  cfg.oledRotateSec = prefs.getUChar("orot", cfg.oledRotateSec);
  cfg.oledPopupSec = prefs.getUChar("opop", cfg.oledPopupSec);
  cfg.oledWeatherMaxAgeMin = prefs.getUShort("owxage", cfg.oledWeatherMaxAgeMin);
  cfg.rfAdminEnabled = prefs.getBool("rfadm", cfg.rfAdminEnabled);
  cfg.rfAdmin1 = prefs.getString("rfadm1", cfg.rfAdmin1);
  cfg.rfAdmin2 = prefs.getString("rfadm2", cfg.rfAdmin2);
  cfg.rfAdminReplyPath = prefs.getString("rfadmpath", cfg.rfAdminReplyPath);
  prefs.end();

  cfg.call = sanitizeBaseCall(cfg.call);

  // REV1F keeps the REV1E i/time/hops migration: if it was typed into the old
  // Server filter field, move it to the local device filter automatically.
  String migratedFilter = cfg.isFilter; migratedFilter.trim(); migratedFilter.toLowerCase();
  if (migratedFilter.startsWith("i/")) {
    cfg.localIsRfFilter = cfg.isFilter;
    cfg.isFilter = "";
    cfg.isToRfEnabled = true;
  }
  if (!parseLocalIsRfFilter(cfg.localIsRfFilter).valid) cfg.localIsRfFilter = "i/30/0";
  cfg.isToRfPath.trim(); cfg.isToRfPath.toUpperCase();

  cfg.ssid = constrain(cfg.ssid, (uint8_t)0, (uint8_t)15);
  cfg.lat = constrain(cfg.lat, -90.0, 90.0);
  cfg.lon = constrain(cfg.lon, -180.0, 180.0);
  cfg.txLevel = constrain(cfg.txLevel, (uint8_t)10, (uint8_t)100);
  cfg.rxSquelch = constrain(cfg.rxSquelch, (uint16_t)5, (uint16_t)1000);
  if (cfg.rxDecoderGain != 0) cfg.rxDecoderGain = constrain(cfg.rxDecoderGain, (uint16_t)20, (uint16_t)500);

  // REV1F one-time audio migration. REV1A-E used 65% as the default TX DAC
  // level. If the stored value is still exactly that old default, move it to
  // 90%. Any user-tuned value is preserved.
  if (audioTuneRev < 1) {
    if (cfg.txLevel == 65) cfg.txLevel = 90;
    prefs.begin("nusaaprs", false);
    prefs.putUChar("audrev", 1);
    prefs.putUChar("txlvl", cfg.txLevel);
    prefs.end();
  }
  cfg.beaconSec = constrain(cfg.beaconSec, 30UL, 86400UL);
  cfg.trackerPositionMode = constrain(cfg.trackerPositionMode, (uint8_t)TRACK_POS_STATIC, (uint8_t)TRACK_POS_AUTO);
  if (cfg.gpsBaud != 9600UL && cfg.gpsBaud != 38400UL && cfg.gpsBaud != 115200UL) cfg.gpsBaud = 9600UL;
  cfg.gpsRxPin = constrain(cfg.gpsRxPin, -1, 39);
  cfg.gpsTxPin = constrain(cfg.gpsTxPin, -1, 39);
  cfg.gpsStaleSec = constrain(cfg.gpsStaleSec, (uint16_t)5, (uint16_t)120);
  if (cfg.trackerOutput < TRACK_OUT_RF || cfg.trackerOutput > TRACK_OUT_BOTH) cfg.trackerOutput = TRACK_OUT_RF;
  cfg.trackerRfPath.trim(); cfg.trackerRfPath.toUpperCase();
  if (cfg.trackerRfPath == "DIRECT") cfg.trackerRfPath = "";
  if (!validPathText(cfg.trackerRfPath)) cfg.trackerRfPath = "WIDE2-1";
  cfg.trackerComment = singleLine(cfg.trackerComment); if (cfg.trackerComment.length() > 100) cfg.trackerComment.remove(100);
  if (cfg.trackerBeaconMode > TRACK_MODE_SMART) cfg.trackerBeaconMode = TRACK_MODE_FIXED;
  cfg.trackerFixedSec = constrain(cfg.trackerFixedSec, (uint16_t)30, (uint16_t)3600);
  cfg.smartSlowSpeedKmh = constrain(cfg.smartSlowSpeedKmh, (uint16_t)1, (uint16_t)100);
  cfg.smartSlowRateSec = constrain(cfg.smartSlowRateSec, (uint16_t)60, (uint16_t)3600);
  cfg.smartFastSpeedKmh = constrain(cfg.smartFastSpeedKmh, (uint16_t)10, (uint16_t)300);
  if (cfg.smartFastSpeedKmh <= cfg.smartSlowSpeedKmh) cfg.smartFastSpeedKmh = cfg.smartSlowSpeedKmh + 1;
  cfg.smartFastRateSec = constrain(cfg.smartFastRateSec, (uint16_t)15, (uint16_t)600);
  cfg.smartTurnAngleDeg = constrain(cfg.smartTurnAngleDeg, (uint16_t)5, (uint16_t)90);
  cfg.smartTurnSlope = constrain(cfg.smartTurnSlope, (uint16_t)1, (uint16_t)1000);
  cfg.smartTurnTimeSec = constrain(cfg.smartTurnTimeSec, (uint16_t)5, (uint16_t)120);
  cfg.stationarySpeedKmh = constrain(cfg.stationarySpeedKmh, (uint16_t)0, (uint16_t)30);
  cfg.trackerMinTxSec = constrain(cfg.trackerMinTxSec, (uint16_t)5, (uint16_t)300);
  if (cfg.apPass.length() < 8) cfg.apPass = "12345678";
  cfg.oledSdaPin = constrain(cfg.oledSdaPin, 0, 33);
  cfg.oledSclPin = constrain(cfg.oledSclPin, 0, 33);
  if (cfg.oledAddress != 0x3C && cfg.oledAddress != 0x3D) cfg.oledAddress = 0;
  cfg.oledRotateSec = constrain(cfg.oledRotateSec, (uint8_t)2, (uint8_t)30);
  cfg.oledPopupSec = constrain(cfg.oledPopupSec, (uint8_t)3, (uint8_t)30);
  cfg.oledWeatherMaxAgeMin = constrain(cfg.oledWeatherMaxAgeMin, (uint16_t)1, (uint16_t)1440);
  cfg.rfAdmin1 = normalizeCallSsid(cfg.rfAdmin1);
  cfg.rfAdmin2 = normalizeCallSsid(cfg.rfAdmin2);
  if (cfg.rfAdmin2.length() && cfg.rfAdmin2 == cfg.rfAdmin1) cfg.rfAdmin2 = "";
  cfg.rfAdminReplyPath.trim(); cfg.rfAdminReplyPath.toUpperCase();
  if (cfg.rfAdminReplyPath == "DIRECT") cfg.rfAdminReplyPath = "";
  if (!validPathText(cfg.rfAdminReplyPath)) cfg.rfAdminReplyPath = "";
  if (!cfg.rfAdmin1.length() && !cfg.rfAdmin2.length()) cfg.rfAdminEnabled = false;
}

static void saveConfigFromWeb() {
  cfg.call = sanitizeBaseCall(web.arg("call"));
  cfg.ssid = constrain(web.arg("ssid").toInt(), 0, 15);
  cfg.dest = singleLine(web.arg("dest")); cfg.dest.trim(); cfg.dest.toUpperCase();
  AX25Call destCheck{}; if (!parseCallText(cfg.dest, destCheck)) cfg.dest = "APNU01";
  cfg.wifiSsid = web.arg("wssid");
  if (web.arg("wpass").length()) cfg.wifiPass = web.arg("wpass");
  cfg.apSsid = web.arg("apssid");
  if (cfg.apSsid.length() < 1) cfg.apSsid = "NUSA-APRS-IGATE";
  if (web.arg("appass").length() >= 8) cfg.apPass = web.arg("appass");

  cfg.isServer = singleLine(web.arg("server")); cfg.isServer.trim();
  cfg.isPort = constrain(web.arg("port").toInt(), 1, 65535);
  cfg.isPasscode = web.arg("ispass").toInt();
  cfg.isFilter = singleLine(web.arg("filter")); cfg.isFilter.trim();
  cfg.igateEnabled = web.hasArg("igate");
  cfg.autoModeSwitchEnabled = web.hasArg("automode");

  cfg.isToRfEnabled = web.hasArg("is2rf");
  cfg.localIsRfFilter = singleLine(web.arg("localfilter")); cfg.localIsRfFilter.trim(); cfg.localIsRfFilter.toLowerCase();
  cfg.isToRfPath = singleLine(web.arg("isrfpath")); cfg.isToRfPath.trim(); cfg.isToRfPath.toUpperCase();

  // Friendly migration: i/30/0 typed into Server filter is treated as the
  // local device filter instead of being sent to APRS-IS.
  String serverFilterLower = cfg.isFilter; serverFilterLower.toLowerCase();
  if (serverFilterLower.startsWith("i/")) {
    cfg.localIsRfFilter = cfg.isFilter; cfg.localIsRfFilter.toLowerCase();
    cfg.isFilter = "";
    cfg.isToRfEnabled = true;
  }
  if (!parseLocalIsRfFilter(cfg.localIsRfFilter).valid) cfg.localIsRfFilter = "i/30/0";

  cfg.digiEnabled = web.hasArg("digi");
  cfg.digiAliases = web.arg("alias"); cfg.digiAliases.trim(); cfg.digiAliases.toUpperCase();
  cfg.digiDelayMs = constrain(web.arg("ddelay").toInt(), 0, 3000);
  cfg.duplicateSec = constrain(web.arg("dupsec").toInt(), 5, 300);

  cfg.rfBeaconEnabled = web.hasArg("rfbcn");
  cfg.isBeaconEnabled = web.hasArg("isbcn");
  cfg.beaconSec = constrain((uint32_t)web.arg("bsec").toInt(), 30UL, 86400UL);
  cfg.lat = constrain(web.arg("lat").toDouble(), -90.0, 90.0);
  cfg.lon = constrain(web.arg("lon").toDouble(), -180.0, 180.0);
  String st = web.arg("symtbl"); cfg.symbolTable = st.length() ? st[0] : '/';
  String sc = web.arg("sym"); cfg.symbolCode = sc.length() ? sc[0] : '#';
  cfg.comment = singleLine(web.arg("comment"));
  cfg.rfPath = singleLine(web.arg("path")); cfg.rfPath.trim(); cfg.rfPath.toUpperCase();

  cfg.trackerEnabled = web.hasArg("trken");
  cfg.trackerPositionMode = (uint8_t)constrain(web.arg("posmode").toInt(), 0, 2);
  cfg.gpsRxPin = constrain(web.arg("gpsrx").toInt(), -1, 39);
  cfg.gpsTxPin = constrain(web.arg("gpstx").toInt(), -1, 39);
  {
    uint32_t b = (uint32_t)web.arg("gpsbaud").toInt();
    cfg.gpsBaud = (b == 38400UL || b == 115200UL) ? b : 9600UL;
  }
  cfg.gpsStaleSec = (uint16_t)constrain(web.arg("gpsstale").toInt(), 5, 120);
  cfg.trackerOutput = (uint8_t)constrain(web.arg("trout").toInt(), 1, 3);
  cfg.trackerRfPath = singleLine(web.arg("trpath")); cfg.trackerRfPath.trim(); cfg.trackerRfPath.toUpperCase();
  if (cfg.trackerRfPath == "DIRECT") cfg.trackerRfPath = "";
  if (!validPathText(cfg.trackerRfPath)) cfg.trackerRfPath = "WIDE2-1";
  String tst = web.arg("trsymt"); cfg.trackerSymbolTable = tst.length() ? tst[0] : '/';
  String tsc = web.arg("trsym"); cfg.trackerSymbolCode = tsc.length() ? tsc[0] : '>';
  cfg.trackerComment = singleLine(web.arg("trcomm")); if (cfg.trackerComment.length() > 100) cfg.trackerComment.remove(100);
  cfg.trackerBeaconMode = (web.arg("trmode").toInt() == TRACK_MODE_SMART) ? TRACK_MODE_SMART : TRACK_MODE_FIXED;
  cfg.trackerFixedSec = (uint16_t)constrain(web.arg("trsec").toInt(), 30, 3600);
  cfg.smartSlowSpeedKmh = (uint16_t)constrain(web.arg("sslow").toInt(), 1, 100);
  cfg.smartSlowRateSec = (uint16_t)constrain(web.arg("srslow").toInt(), 60, 3600);
  cfg.smartFastSpeedKmh = (uint16_t)constrain(web.arg("sfast").toInt(), 10, 300);
  if (cfg.smartFastSpeedKmh <= cfg.smartSlowSpeedKmh) cfg.smartFastSpeedKmh = cfg.smartSlowSpeedKmh + 1;
  cfg.smartFastRateSec = (uint16_t)constrain(web.arg("srfast").toInt(), 15, 600);
  cfg.smartTurnAngleDeg = (uint16_t)constrain(web.arg("sturn").toInt(), 5, 90);
  cfg.smartTurnSlope = (uint16_t)constrain(web.arg("sslope").toInt(), 1, 1000);
  cfg.smartTurnTimeSec = (uint16_t)constrain(web.arg("sturnt").toInt(), 5, 120);
  cfg.stationarySpeedKmh = (uint16_t)constrain(web.arg("sstat").toInt(), 0, 30);
  cfg.trackerMinTxSec = (uint16_t)constrain(web.arg("trmin").toInt(), 5, 300);

  cfg.preambleMs = constrain(web.arg("pre").toInt(), 50, 1500);
  cfg.tailMs = constrain(web.arg("tail").toInt(), 20, 1000);
  cfg.txLevel = constrain(web.arg("txlvl").toInt(), 10, 100);
  cfg.rxSquelch = constrain(web.arg("rxsql").toInt(), 5, 1000);
  {
    int rg = web.arg("rxgain").toInt();
    cfg.rxDecoderGain = (rg <= 0) ? 0 : (uint16_t)constrain(rg, 20, 500);
  }
  cfg.pttPin = constrain(web.arg("pttpin").toInt(), -1, 39);
  cfg.pttActiveHigh = web.hasArg("ptthi");
  cfg.rxLedPin = constrain(web.arg("rxled").toInt(), -1, 39);
  cfg.txLedPin = constrain(web.arg("txled").toInt(), -1, 39);

  cfg.oledEnabled = web.hasArg("oled");
  cfg.oledSdaPin = constrain(web.arg("osda").toInt(), 0, 33);
  cfg.oledSclPin = constrain(web.arg("oscl").toInt(), 0, 33);
  {
    String oa = web.arg("oaddr"); oa.trim(); oa.toLowerCase();
    cfg.oledAddress = (oa == "0x3c" || oa == "3c") ? 0x3C : ((oa == "0x3d" || oa == "3d") ? 0x3D : 0);
  }
  cfg.oledController = (web.arg("octrl") == "ssd1306") ? 1 : 2;
  cfg.oledContrast = (uint8_t)constrain(web.arg("ocon").toInt(), 1, 255);
  cfg.oledFlip = web.hasArg("oflip");
  cfg.oledRotateSec = (uint8_t)constrain(web.arg("orot").toInt(), 2, 30);
  cfg.oledPopupSec = (uint8_t)constrain(web.arg("opop").toInt(), 3, 30);
  cfg.oledWeatherMaxAgeMin = (uint16_t)constrain(web.arg("owxage").toInt(), 1, 1440);

  cfg.rfAdminEnabled = web.hasArg("rfadm");
  cfg.rfAdmin1 = normalizeCallSsid(singleLine(web.arg("rfadm1")));
  cfg.rfAdmin2 = normalizeCallSsid(singleLine(web.arg("rfadm2")));
  if (cfg.rfAdmin2.length() && cfg.rfAdmin2 == cfg.rfAdmin1) cfg.rfAdmin2 = "";
  cfg.rfAdminReplyPath = singleLine(web.arg("rfadmpath")); cfg.rfAdminReplyPath.trim(); cfg.rfAdminReplyPath.toUpperCase();
  if (cfg.rfAdminReplyPath == "DIRECT") cfg.rfAdminReplyPath = "";
  if (!validPathText(cfg.rfAdminReplyPath)) cfg.rfAdminReplyPath = "";
  if (!cfg.rfAdmin1.length() && !cfg.rfAdmin2.length()) cfg.rfAdminEnabled = false;

  prefs.begin("nusaaprs", false);
  prefs.putString("call", cfg.call); prefs.putUChar("ssid", cfg.ssid); prefs.putString("dest", cfg.dest);
  prefs.putString("wssid", cfg.wifiSsid); prefs.putString("wpass", cfg.wifiPass);
  prefs.putString("apssid", cfg.apSsid); prefs.putString("appass", cfg.apPass);
  prefs.putString("server", cfg.isServer); prefs.putUShort("port", cfg.isPort); prefs.putInt("ispass", cfg.isPasscode);
  prefs.putString("filter", cfg.isFilter); prefs.putBool("igate", cfg.igateEnabled); prefs.putBool("automode", cfg.autoModeSwitchEnabled);
  prefs.putBool("is2rf", cfg.isToRfEnabled); prefs.putString("isrfflt", cfg.localIsRfFilter); prefs.putString("isrfpath", cfg.isToRfPath);
  prefs.putBool("digi", cfg.digiEnabled); prefs.putString("alias", cfg.digiAliases);
  prefs.putUShort("ddelay", cfg.digiDelayMs); prefs.putUShort("dupsec", cfg.duplicateSec);
  prefs.putBool("rfbcn", cfg.rfBeaconEnabled); prefs.putBool("isbcn", cfg.isBeaconEnabled); prefs.putUInt("bsec", cfg.beaconSec);
  prefs.putDouble("lat", cfg.lat); prefs.putDouble("lon", cfg.lon); prefs.putString("symtbl", String(cfg.symbolTable)); prefs.putString("sym", String(cfg.symbolCode));
  prefs.putString("comment", cfg.comment); prefs.putString("path", cfg.rfPath);
  prefs.putBool("trken", cfg.trackerEnabled); prefs.putUChar("posmode", cfg.trackerPositionMode);
  prefs.putInt("gpsrx", cfg.gpsRxPin); prefs.putInt("gpstx", cfg.gpsTxPin); prefs.putUInt("gpsbaud", cfg.gpsBaud); prefs.putUShort("gpsstale", cfg.gpsStaleSec);
  prefs.putUChar("trout", cfg.trackerOutput); prefs.putString("trpath", cfg.trackerRfPath);
  prefs.putString("trsymt", String(cfg.trackerSymbolTable)); prefs.putString("trsym", String(cfg.trackerSymbolCode)); prefs.putString("trcomm", cfg.trackerComment);
  prefs.putUChar("trmode", cfg.trackerBeaconMode); prefs.putUShort("trsec", cfg.trackerFixedSec);
  prefs.putUShort("sslow", cfg.smartSlowSpeedKmh); prefs.putUShort("srslow", cfg.smartSlowRateSec);
  prefs.putUShort("sfast", cfg.smartFastSpeedKmh); prefs.putUShort("srfast", cfg.smartFastRateSec);
  prefs.putUShort("sturn", cfg.smartTurnAngleDeg); prefs.putUShort("sslope", cfg.smartTurnSlope); prefs.putUShort("sturnt", cfg.smartTurnTimeSec);
  prefs.putUShort("sstat", cfg.stationarySpeedKmh); prefs.putUShort("trmin", cfg.trackerMinTxSec);
  prefs.putUShort("pre", cfg.preambleMs); prefs.putUShort("tail", cfg.tailMs); prefs.putUChar("txlvl", cfg.txLevel); prefs.putUShort("rxsql", cfg.rxSquelch); prefs.putUShort("rxgain", cfg.rxDecoderGain); prefs.putUChar("audrev", 1);
  prefs.putInt("pttpin", cfg.pttPin); prefs.putBool("ptthi", cfg.pttActiveHigh); prefs.putInt("rxled", cfg.rxLedPin); prefs.putInt("txled", cfg.txLedPin);
  prefs.putBool("oled", cfg.oledEnabled); prefs.putInt("osda", cfg.oledSdaPin); prefs.putInt("oscl", cfg.oledSclPin);
  prefs.putUChar("oaddr", cfg.oledAddress); prefs.putUChar("octrl", cfg.oledController); prefs.putUChar("ocon", cfg.oledContrast); prefs.putBool("oflip", cfg.oledFlip);
  prefs.putUChar("orot", cfg.oledRotateSec); prefs.putUChar("opop", cfg.oledPopupSec); prefs.putUShort("owxage", cfg.oledWeatherMaxAgeMin);
  prefs.putBool("rfadm", cfg.rfAdminEnabled); prefs.putString("rfadm1", cfg.rfAdmin1); prefs.putString("rfadm2", cfg.rfAdmin2); prefs.putString("rfadmpath", cfg.rfAdminReplyPath);
  prefs.end();
}

static void applyModemConfig() {
  AFSK_setPtt(cfg.pttPin, cfg.pttActiveHigh);
  AFSK_setLeds(cfg.rxLedPin, cfg.txLedPin);
  AFSK_setPreamble(cfg.preambleMs);
  AFSK_setTail(cfg.tailMs);
  AFSK_setTxLevel(cfg.txLevel);
  AFSK_setRxSquelch(cfg.rxSquelch);
  AFSK_setRxDecoderGain(cfg.rxDecoderGain);
}

static void startWifi() {
  WiFi.mode(WIFI_AP_STA);
  WiFi.setHostname("nusa-aprs-igate");
  bool apOk = WiFi.softAP(cfg.apSsid.c_str(), cfg.apPass.c_str());
  addLog(String("AP ") + (apOk ? "ready " : "FAILED ") + cfg.apSsid + "  IP=" + WiFi.softAPIP().toString());
  if (cfg.wifiSsid.length()) {
    WiFi.begin(cfg.wifiSsid.c_str(), cfg.wifiPass.c_str());
    addLog("WiFi STA connecting to " + cfg.wifiSsid);
  }
}

static void disconnectAprsIs() {
  if (aprsClient.connected()) aprsClient.stop();
  isLineBuffer = "";
}

static void serviceWifi() {
  if (!cfg.wifiSsid.length()) return;
  if (WiFi.status() != WL_CONNECTED && (uint32_t)(millis() - lastWifiRetry) > 30000U) {
    lastWifiRetry = millis();
    WiFi.disconnect();
    WiFi.begin(cfg.wifiSsid.c_str(), cfg.wifiPass.c_str());
  }
}

static void serviceAprsIs() {
  bool trackerNeedsIs = cfg.trackerEnabled && (cfg.trackerOutput == TRACK_OUT_IS || cfg.trackerOutput == TRACK_OUT_BOTH);
  bool needIs = cfg.autoModeSwitchEnabled || cfg.igateEnabled || cfg.isToRfEnabled || cfg.isBeaconEnabled || trackerNeedsIs;
  if (!needIs || WiFi.status() != WL_CONNECTED || sanitizeBaseCall(cfg.call) == "NOCALL") {
    disconnectAprsIs();
    return;
  }

  if (!aprsClient.connected()) {
    if ((uint32_t)(millis() - lastIsConnectAttempt) < 15000U) return;
    lastIsConnectAttempt = millis();
    addLog("APRS-IS connecting " + cfg.isServer + ":" + String(cfg.isPort));
    if (!aprsClient.connect(cfg.isServer.c_str(), cfg.isPort)) {
      addLog("APRS-IS connect failed");
      return;
    }
    aprsClient.setNoDelay(true);
    int pass = cfg.isPasscode > 0 ? cfg.isPasscode : aprsPasscode(stationCall());
    String login = "user " + stationCall() + " pass " + String(pass) + " vers " + APRS_SW + " " + APRS_SW_VER;
    if (cfg.isFilter.length()) login += " filter " + cfg.isFilter;
    aprsClient.print(login + "\r\n");
    addLog("APRS-IS connected / login sent; local IS>RF=" + cfg.localIsRfFilter);
  }

  while (aprsClient.available()) {
    char c = (char)aprsClient.read();
    if (c == '\n') {
      ++isRxLineCount;
      String line = isLineBuffer;
      isLineBuffer = "";
      if (line.length()) processAprsIsLine(line);
    } else if (c != '\r' && isLineBuffer.length() < 600) {
      isLineBuffer += c;
    }
  }
}

static String checked(bool v) { return v ? " checked" : ""; }
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
void loop() {
  web.handleClient();
  serviceWifi();
  serviceAprsIs();
  serviceAutoModeSwitch();

  // GPS UART is additive and bounded: at most 96 bytes are consumed per loop.
  gps.service(96);

  // AX25 poll and RF TX remain ahead of tracker decisions.
  ax25_poll(&ax25);
  serviceRfTx();
  serviceRfAdmin();
  serviceTracker();
  serviceOled();

  uint32_t now = millis();
  if ((uint32_t)(now - lastBeaconMs) >= cfg.beaconSec * 1000UL) {
    lastBeaconMs = now;
    if (cfg.rfBeaconEnabled) sendRfBeacon();
    if (cfg.isBeaconEnabled) sendIsBeacon();
  }
  delay(1);
}
