stefendy-dotcom/NUSA-APRS-ESP32/source/NUSA_APRS_IGATE_DIGI_REV1T_GPS_TRACKER/CRC-CCIT.h

// CRC-CCITT/X.25 implementation compatible with the uploaded header contract.
#ifndef CRC_CCIT_H
#define CRC_CCIT_H

#include <stdint.h>
#include <pgmspace.h>

#define CRC_CCIT_INIT_VAL ((uint16_t)0xFFFF)
extern const uint16_t crc_ccit_table[256];

inline uint16_t update_crc_ccit(uint8_t c, uint16_t prev_crc) {
    return (prev_crc >> 8) ^ pgm_read_word(&crc_ccit_table[(prev_crc ^ c) & 0xff]);
}

#endif
