stefendy-dotcom/NUSA-APRS-ESP32/(commit log)

2026-10-24 feat: initialize NUSA APRS ESP32 REV1S standalone repository
2026-10-24 feat: publish NUSA APRS ESP32 REV1S standalone repository
2026-10-24 fix: restore valid REV1S schematic SVG
2026-10-24 docs: update RF wiring and adjustment to skema.jpeg
2026-11-01 ci: add read-only stefendy-nusa[bot] authentication verifier
    * chore: stage safe stefendy[bot] GitHub App verification workflow
    * docs: stage GitHub App registration and safe NUSA bot migration
    * docs: record staged bot auth migration and manual-only legacy publishing safety
    * ci: target registered stefendy-nusa[bot] GitHub App
    * docs: update NUSA GitHub App setup for stefendy-nusa[bot]
2026-11-06 feat: add REV1T automatic iGate/digipeater mode switching
